Sdevaud/PCB/PCB.pdf

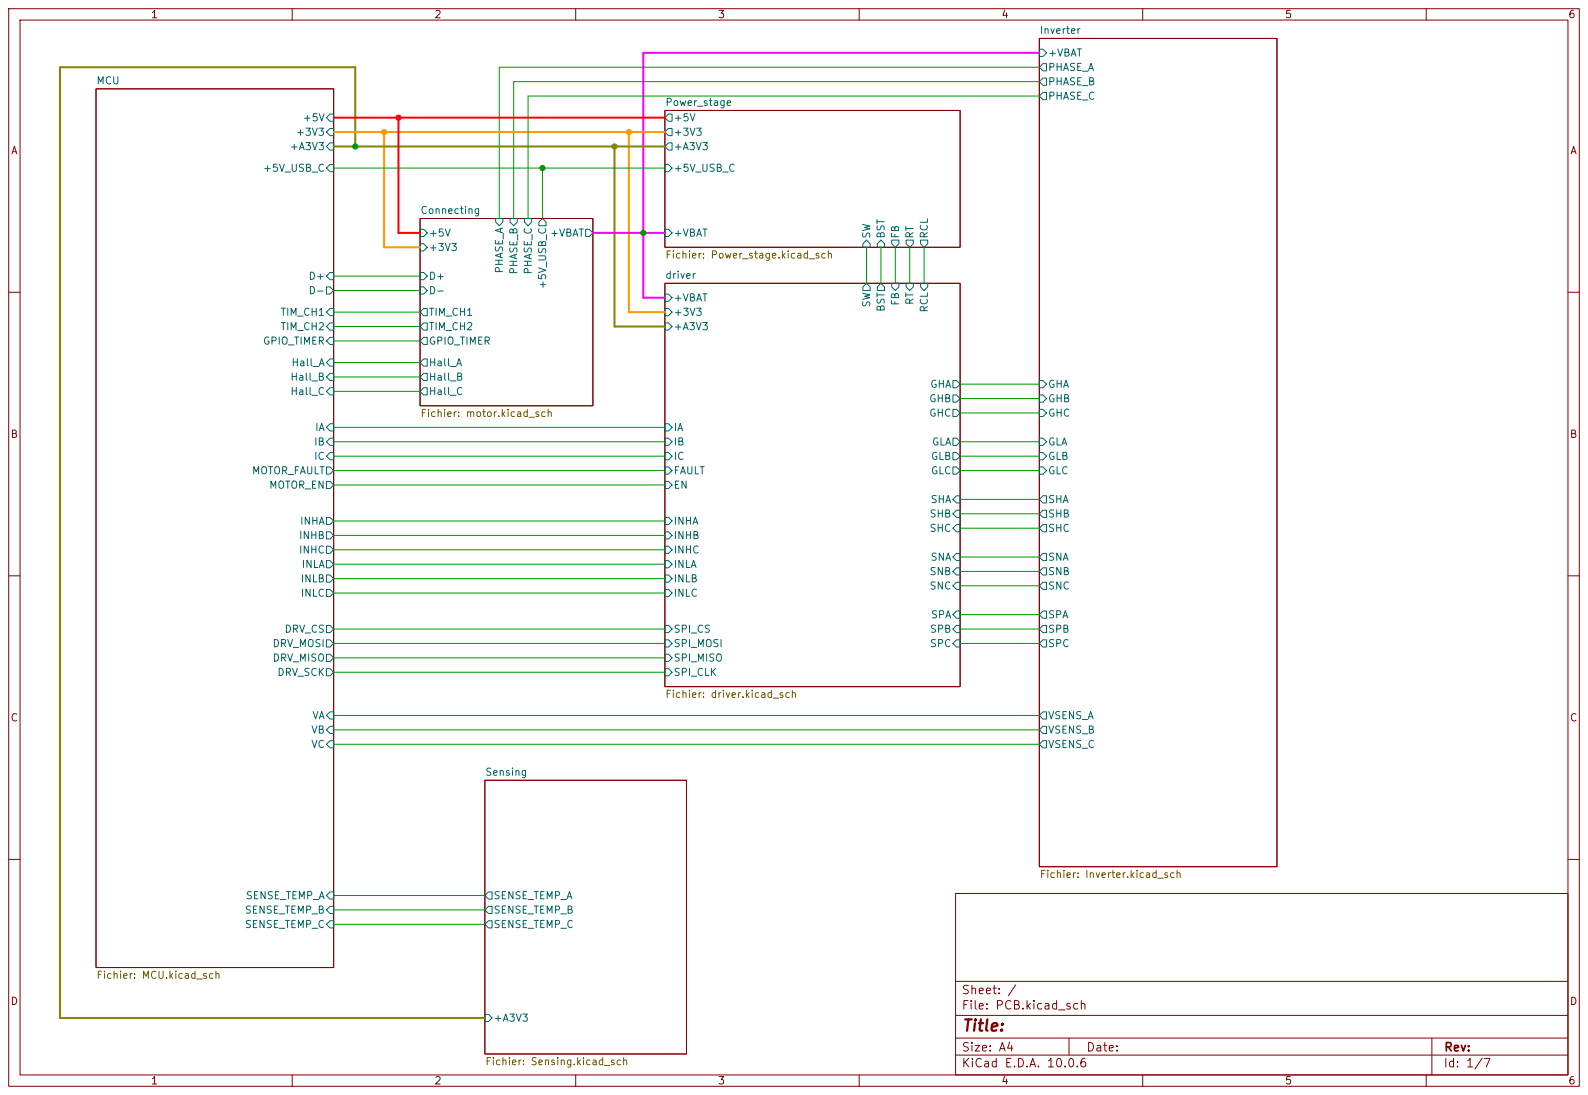
[picture p1: page 1]

Size: A4 | Rev:
KiCad E.D.A. 10.0.6 | Id: 1/7

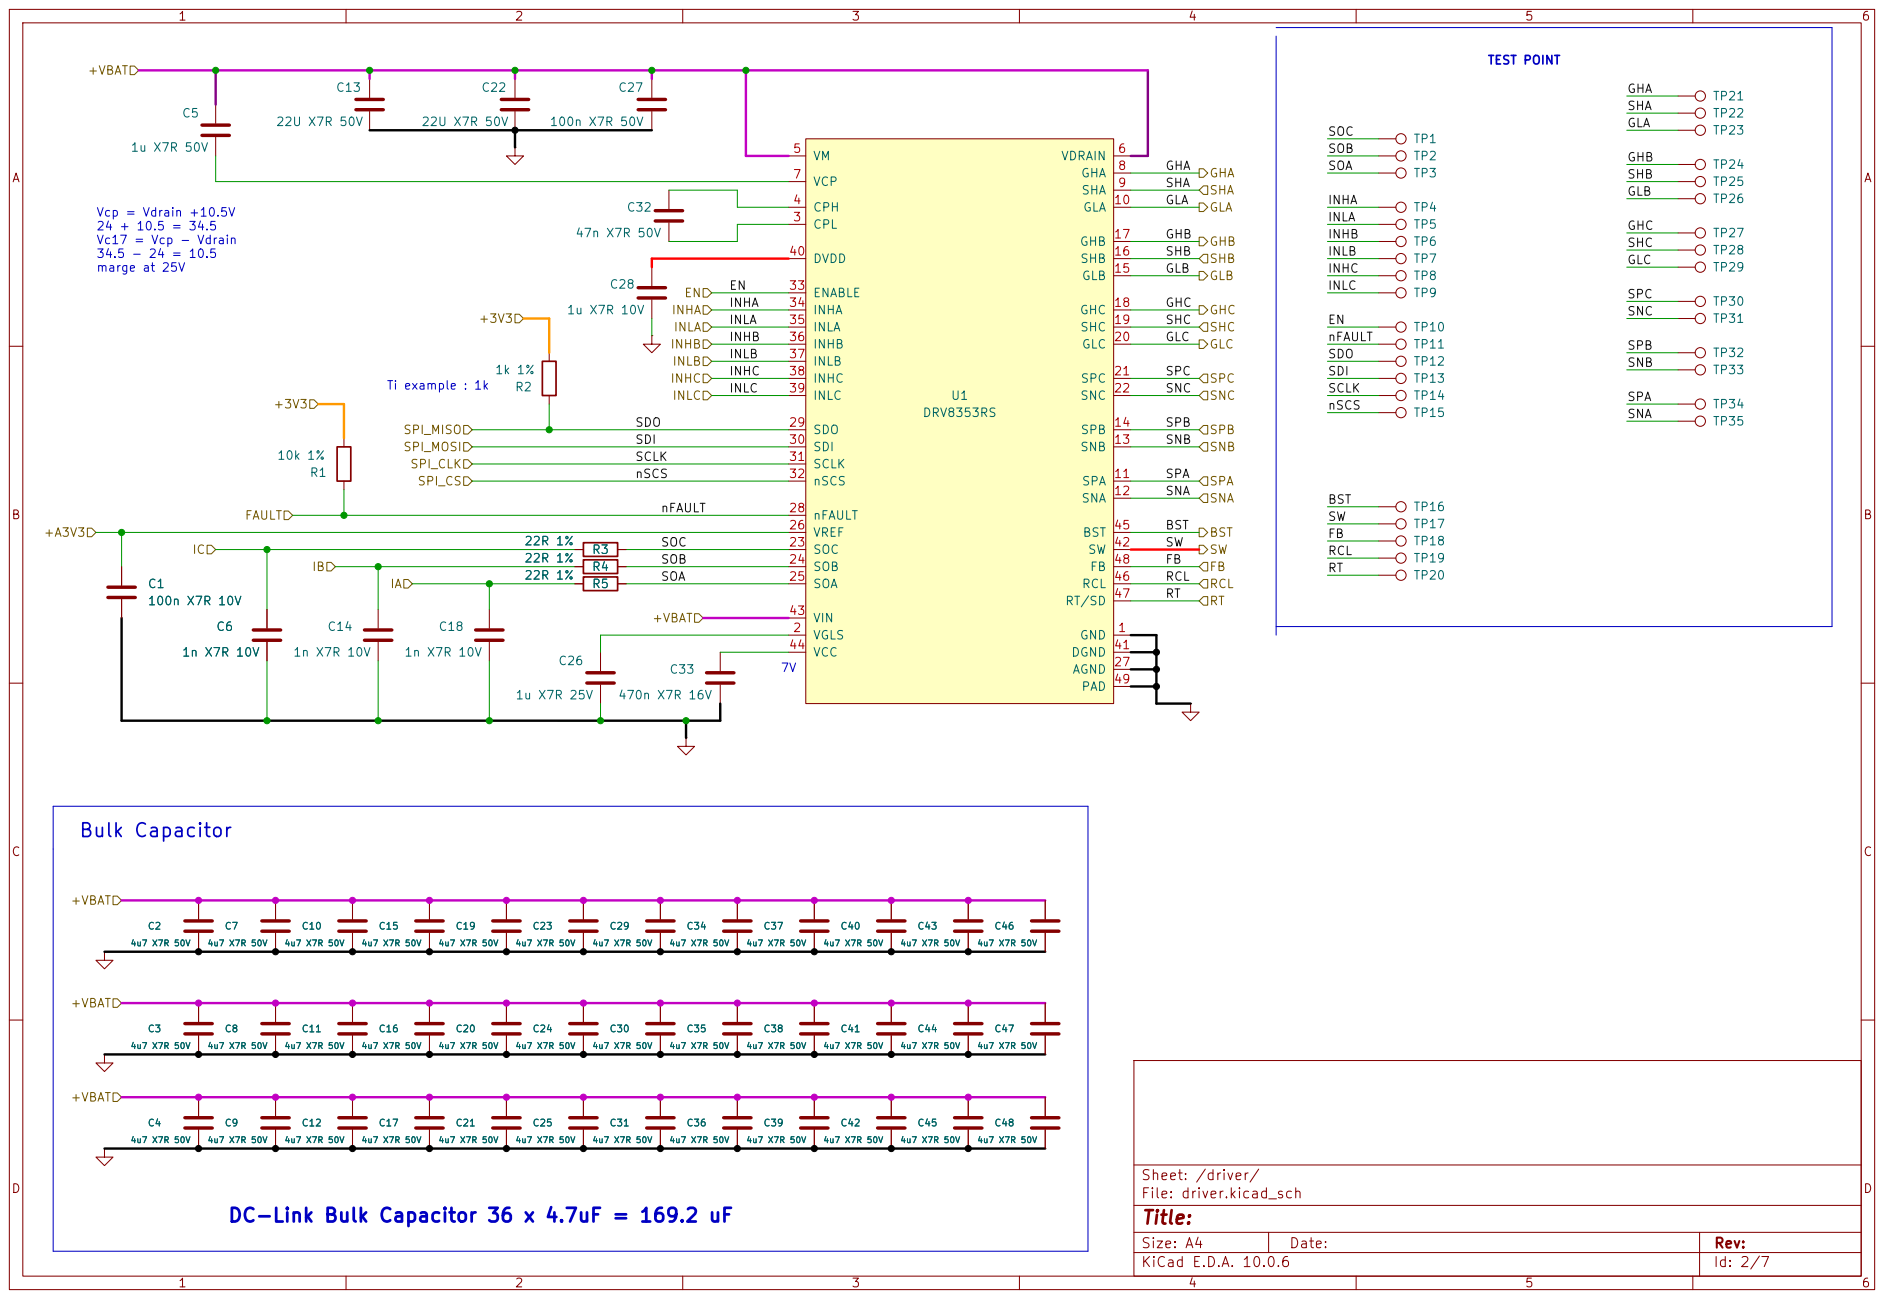
[picture p2: page 2]

TEST POINT 7V Bulk Capacitor
SPI_CS +VBAT

Vc17 = Vcp - Vdrain 34.5 - 24 = 10.5 marge at 25V

DC-Link Bulk Capacitor 36 x 4.7uF = 169.2 uF

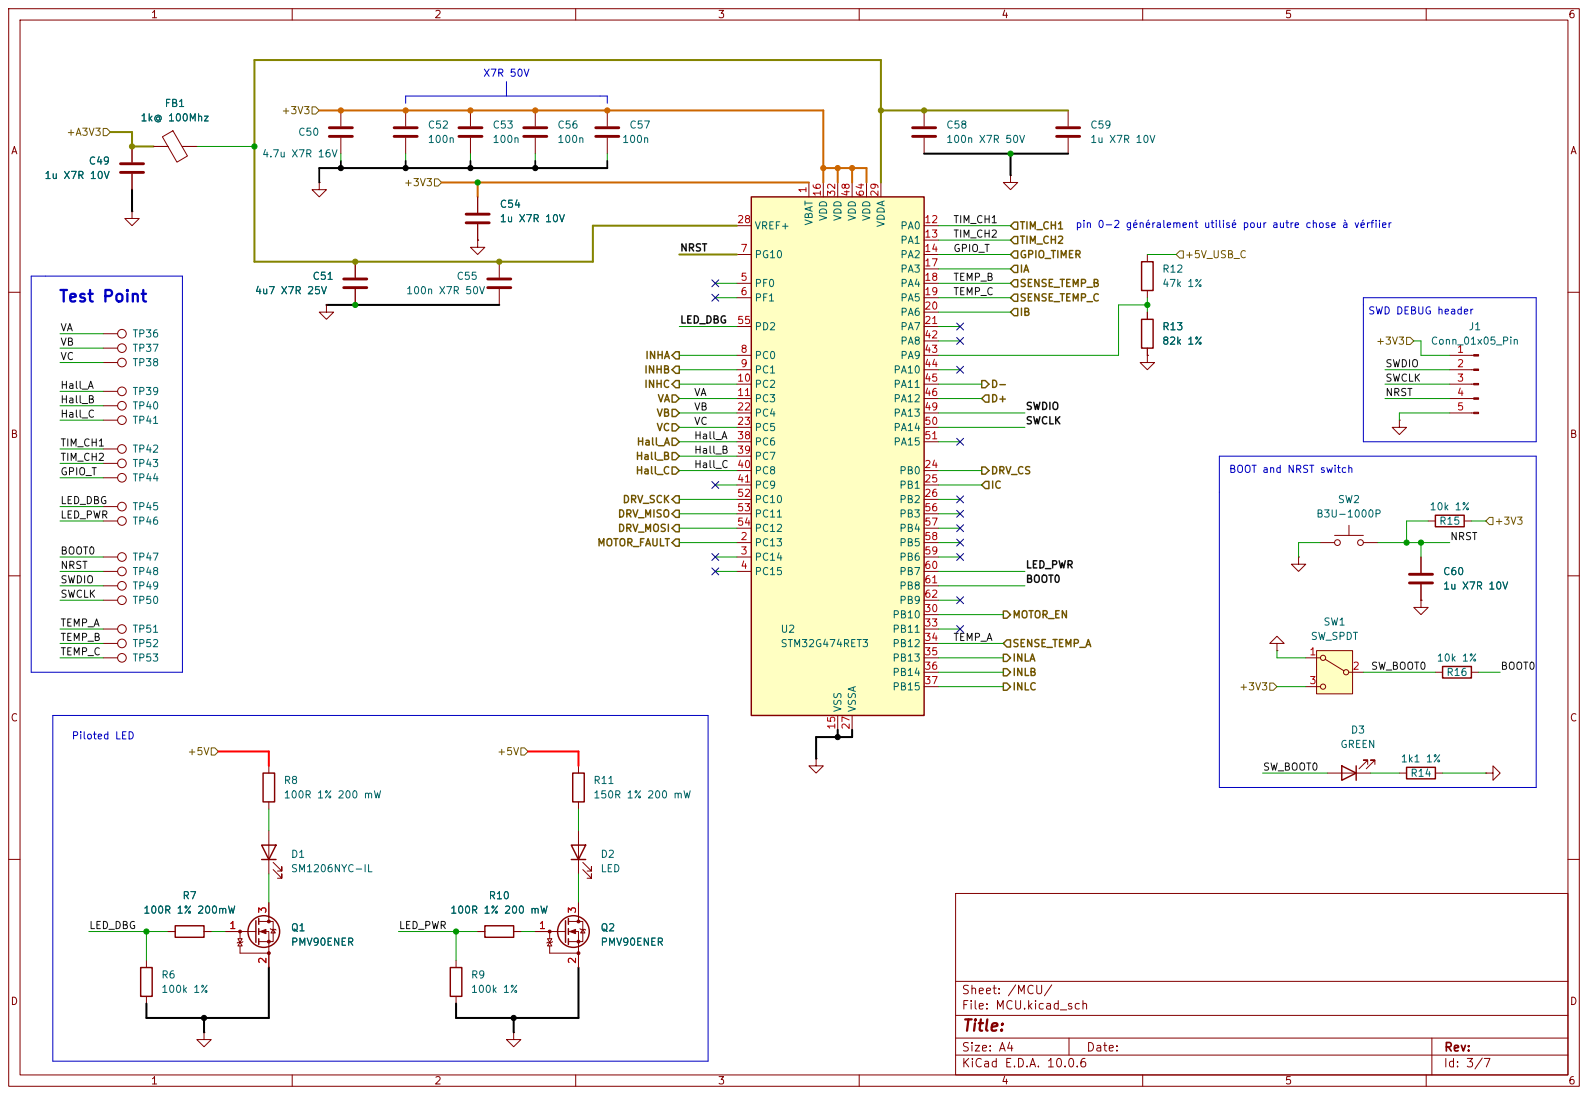
[picture p3: page 3]

pin 0-2 généralement utilisé pour autre chose à vérfiier Piloted LED

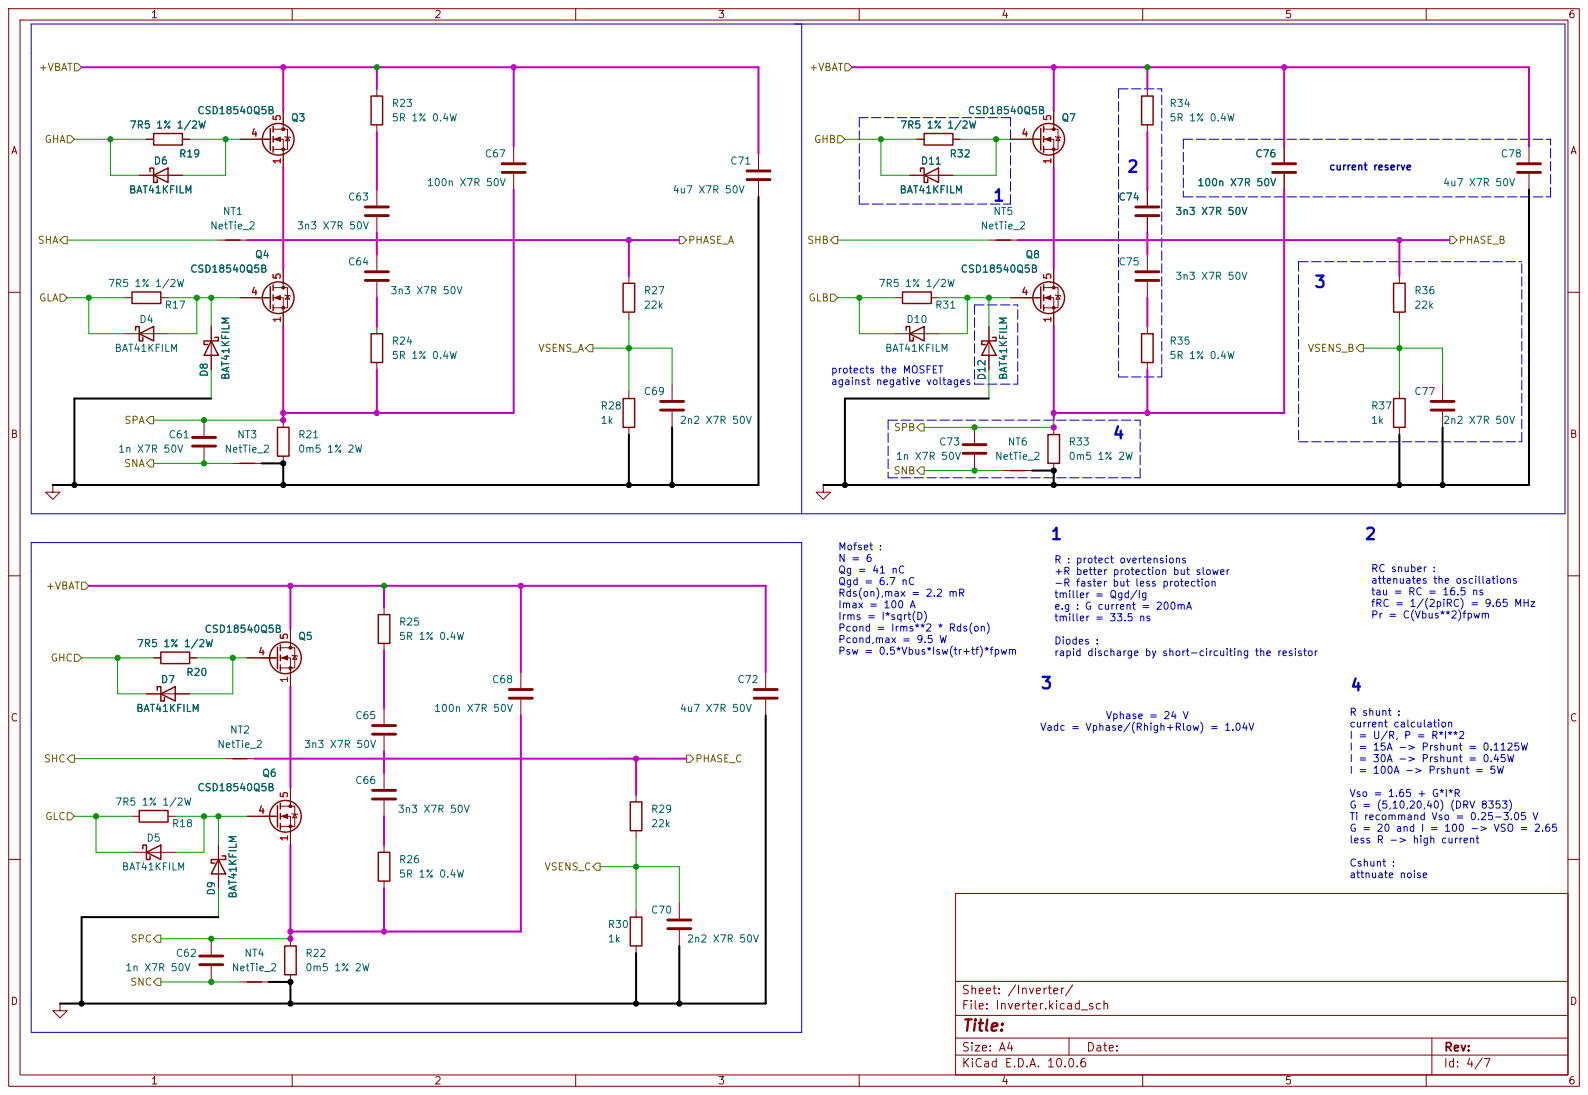
[picture p4: page 4]

Mofset : N = 6 Qg = 41 nC Qgd = 6.7 nC

RC snuber : attenuates the oscillations

Rds(on),max = 2.2 mR
Imax = 100 A
Irms = I*sqrt(D) Pcond = Irms**2 * Rds(on)

tau = RC = 16.5 ns
fRC = 1/(2piRC) = 9.65 MHz Pr = C(Vbus**2)fpwm

Pcond,max = 9.5 W
Psw = 0.5*Vbus*Isw(tr+tf)*fpwm

less R -> high current Cshunt : attnuate noise 3

Vso = 1.65 + G*I*R
G = (5,10,20,40) (DRV 8353) Ti recommand Vso = 0.25-3.05 V G = 20 and I = 100 -> VSO = 2.65

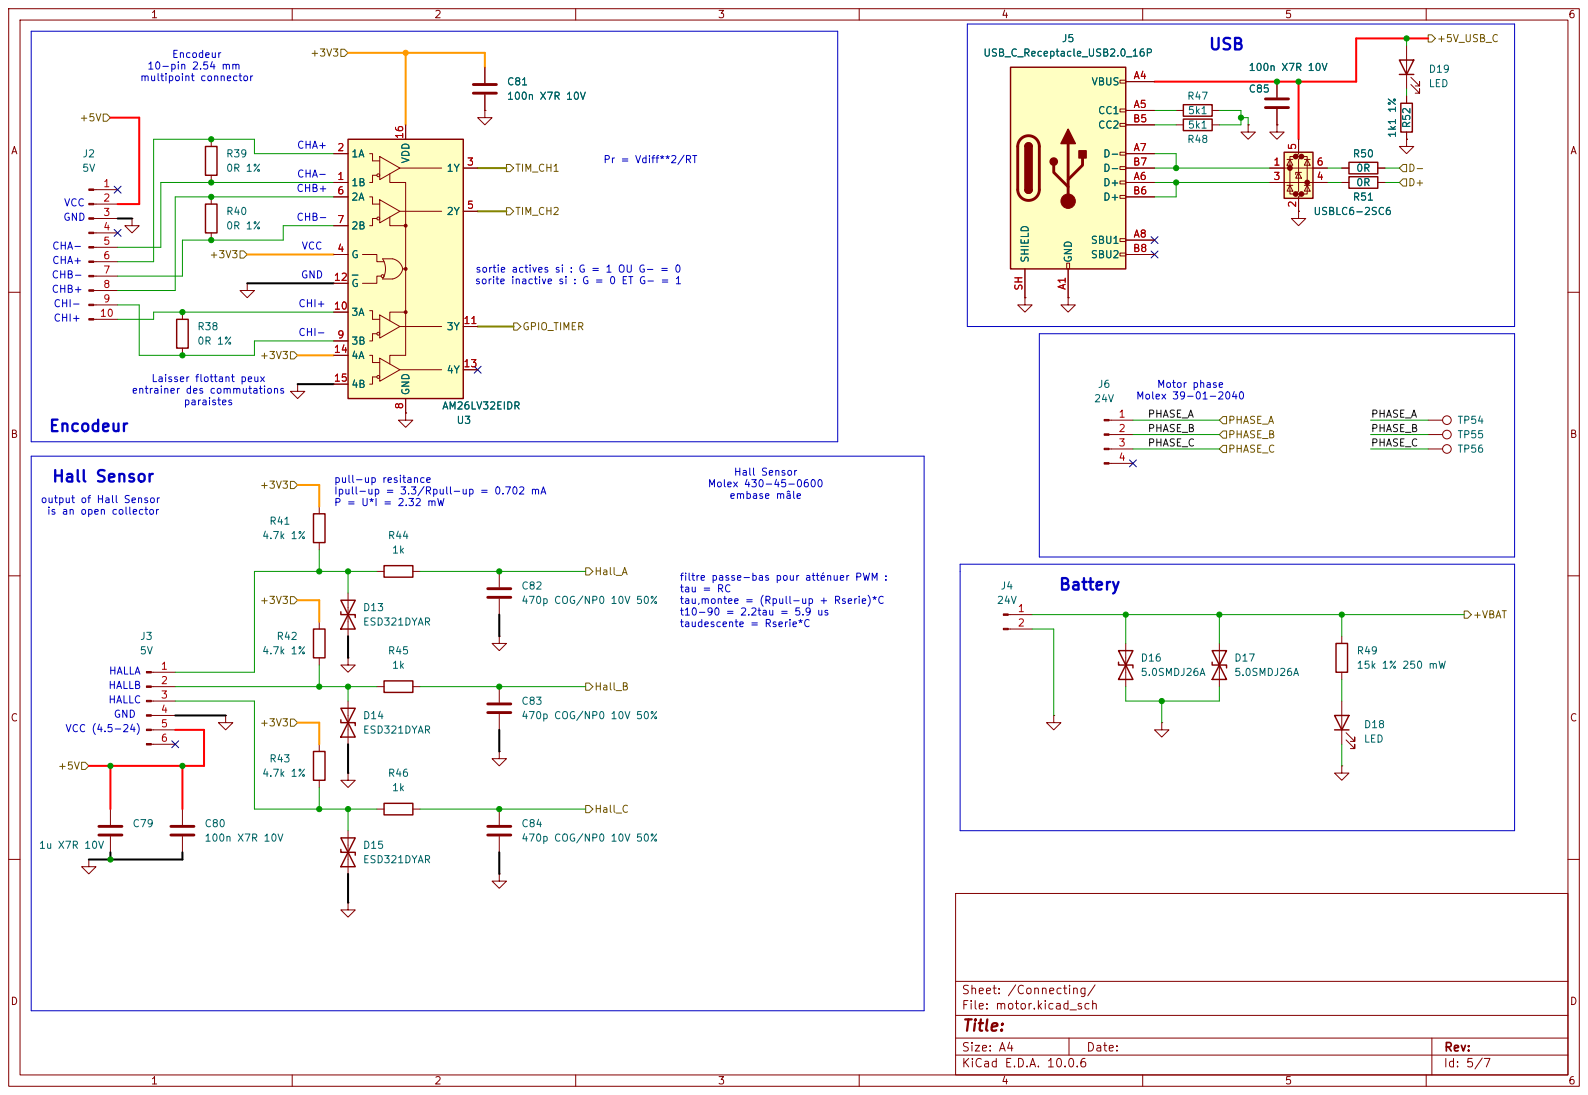
[picture p5: page 5]

Encodeur 10-pin 2.54 mm multipoint connector VCC

sortie actives si : G = 1 OU G- = 0
sorite inactive si : G = 0 ET G- = 1

CHI+
is an open collector VCC (4.5-24) HALLC HALLB

Laisser flottant peux entrainer des commutations paraistes

pull-up resitance
Ipull-up = 3.3/Rpull-up = 0.702 mA P = U*I = 2.32 mW

output of Hall Sensor

filtre passe-bas pour atténuer PWM :
tau = RC
tau,montee = (Rpull-up + Rserie)*C
t10-90 = 2.2tau = 5.9 us
taudescente = Rserie*C

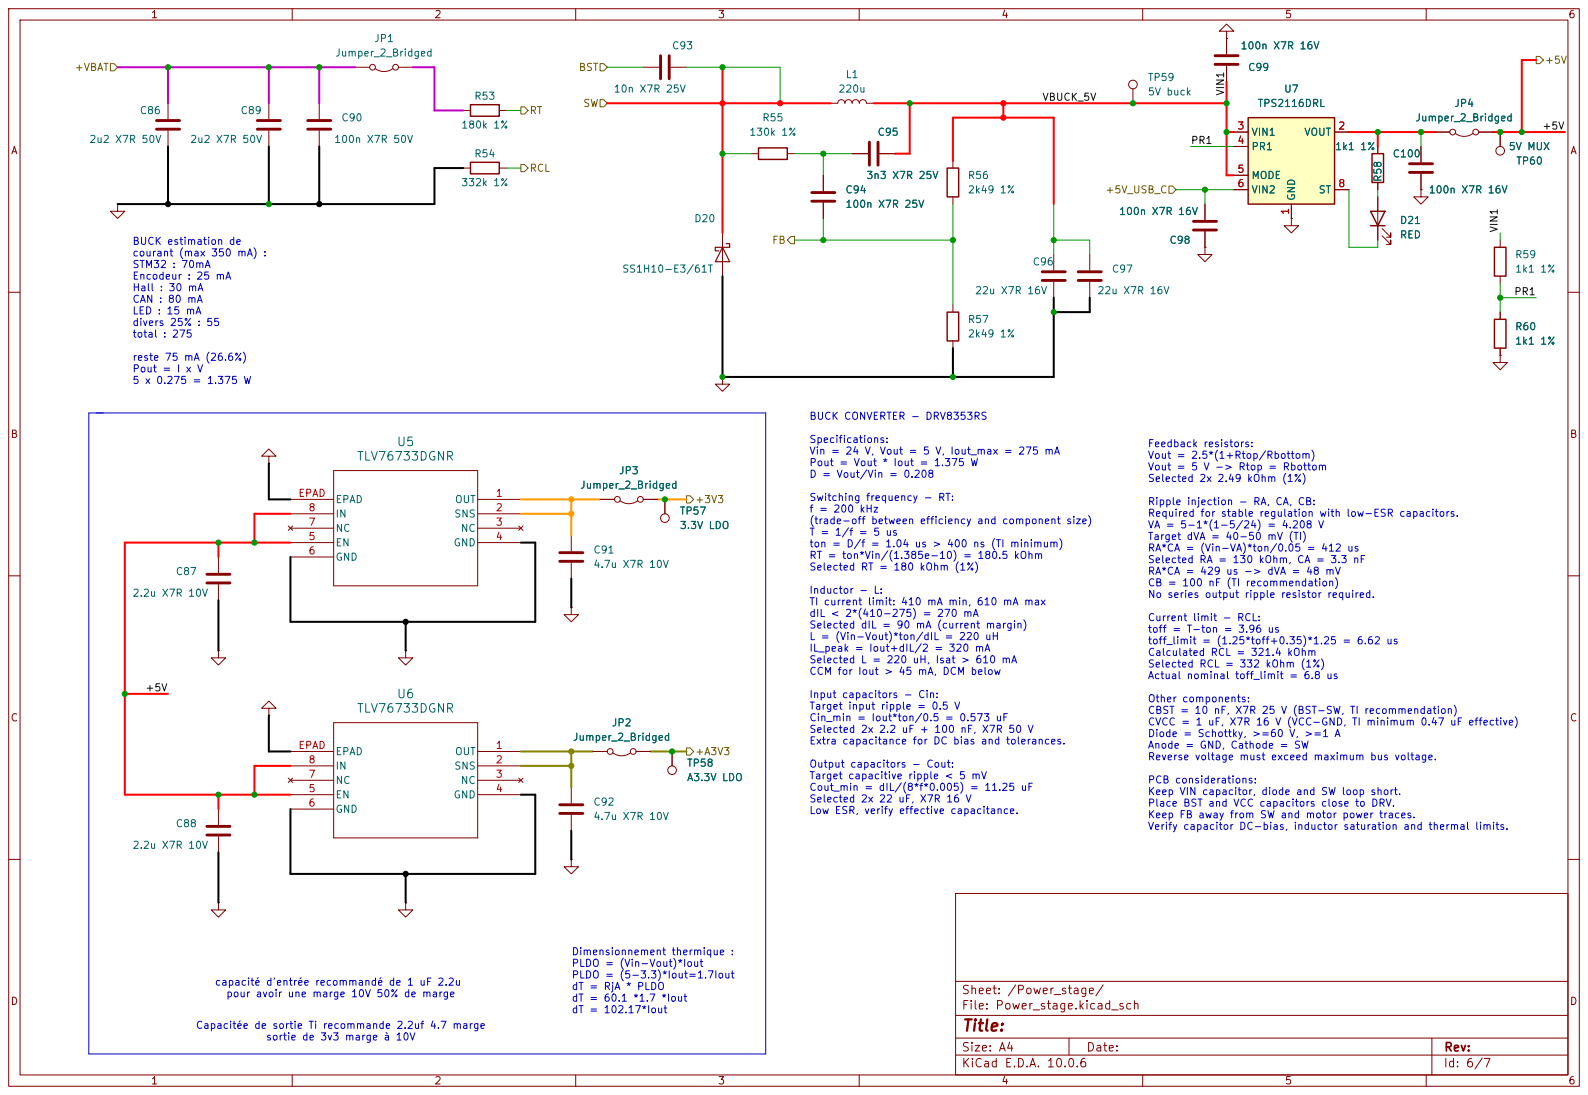
[picture p6: page 6]

BUCK estimation de courant (max 350 mA) : STM32 : 70mA Encodeur : 25 mA Hall : 30 mA CAN : 80 mA

Reverse voltage must exceed maximum bus voltage. PCB considerations: Keep VIN capacitor, diode and SW loop short. Place BST and VCC capacitors close to DRV. Keep FB away from SW and motor power traces. Verify capacitor DC-bias, inductor saturation and thermal limits. BUCK CONVERTER - DRV8353RS

Specifications: Vin = 24 V, Vout = 5 V, Iout_max = 275 mA Pout = Vout * Iout = 1.375 W

Feedback resistors: Vout = 2.5*(1+Rtop/Rbottom) Vout = 5 V -> Rtop = Rbottom

Switching frequency - RT: f = 200 kHz

Ripple injection - RA, CA, CB: Required for stable regulation with low-ESR capacitors. VA = 5-1*(1-5/24) = 4.208 V

(trade-off between efficiency and component size) T = 1/f = 5 us

Target dVA = 40-50 mV (TI) RA*CA = (Vin-VA)*ton/0.05 = 412 us Selected RA = 130 kOhm, CA = 3.3 nF RA*CA = 429 us -> dVA = 48 mV CB = 100 nF (TI recommendation) No series output ripple resistor required. Current limit - RCL: toff = T-ton = 3.96 us

ton = D/f = 1.04 us > 400 ns (TI minimum) RT = ton*Vin/(1.385e-10) = 180.5 kOhm

Inductor - L: TI current limit: 410 mA min, 610 mA max dIL < 2*(410-275) = 270 mA Selected dIL = 90 mA (current margin) L = (Vin-Vout)*ton/dIL = 220 uH

IL_peak = Iout+dIL/2 = 320 mA Selected L = 220 uH, Isat > 610 mA CCM for Iout > 45 mA, DCM below

toff_limit = (1.25*toff+0.35)*1.25 = 6.62 us Calculated RCL = 321.4 kOhm

Selected RCL = 332 kOhm (1%) Actual nominal toff_limit = 6.8 us Other components: CBST = 10 nF, X7R 25 V (BST-SW, TI recommendation) CVCC = 1 uF, X7R 16 V (VCC-GND, TI minimum 0.47 uF effective) Diode = Schottky, >=60 V, >=1 A

Input capacitors - Cin: Target input ripple = 0.5 V Cin_min = Iout*ton/0.5 = 0.573 uF Selected 2x 2.2 uF + 100 nF, X7R 50 V Extra capacitance for DC bias and tolerances. Output capacitors - Cout: Target capacitive ripple < 5 mV Cout_min = dIL/(8*f*0.005) = 11.25 uF Selected 2x 22 uF, X7R 16 V

Anode = GND, Cathode = SW

Low ESR, verify effective capacitance.

Dimensionnement thermique : PLDO = (Vin-Vout)*Iout PLDO = (5-3.3)*Iout=1.7Iout dT = RjA * PLDO

capacité d'entrée recommandé de 1 uF 2.2u pour avoir une marge 10V 50% de marge
dT = 60.1 *1.7 *Iout dT = 102.17*Iout Capacitée de sortie Ti recommande 2.2uf 4.7 marge

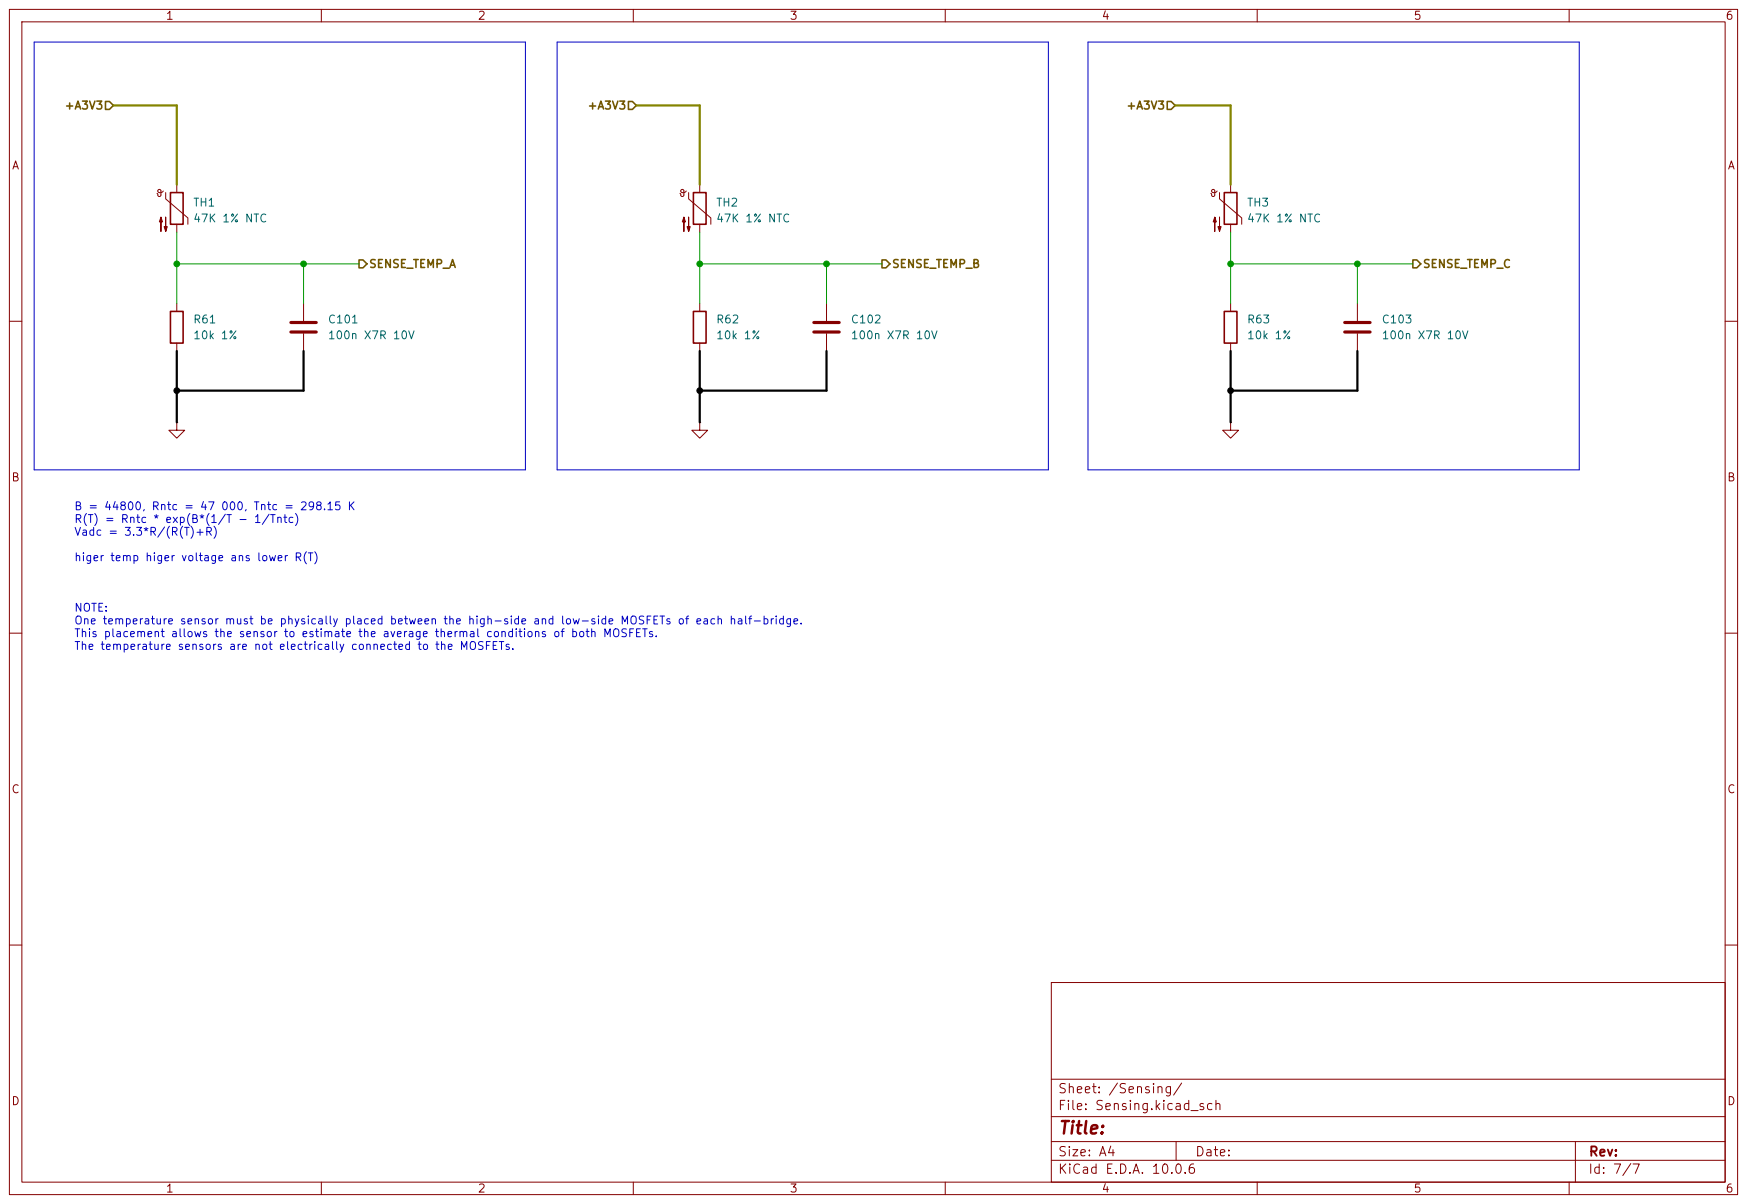
[picture p7: page 7]

R(T) = Rntc * exp(B*(1/T - 1/Tntc) Vadc = 3.3*R/(R(T)+R)

higer temp higer voltage ans lower R(T) NOTE: One temperature sensor must be physically placed between the high-side and low-side MOSFETs of each half-bridge. This placement allows the sensor to estimate the average thermal conditions of both MOSFETs. The temperature sensors are not electrically connected to the MOSFETs.
