Sdevaud/PCB/Inverter.kicad_sch

## KiCad design Inverter.kicad_sch (2026-11-09)

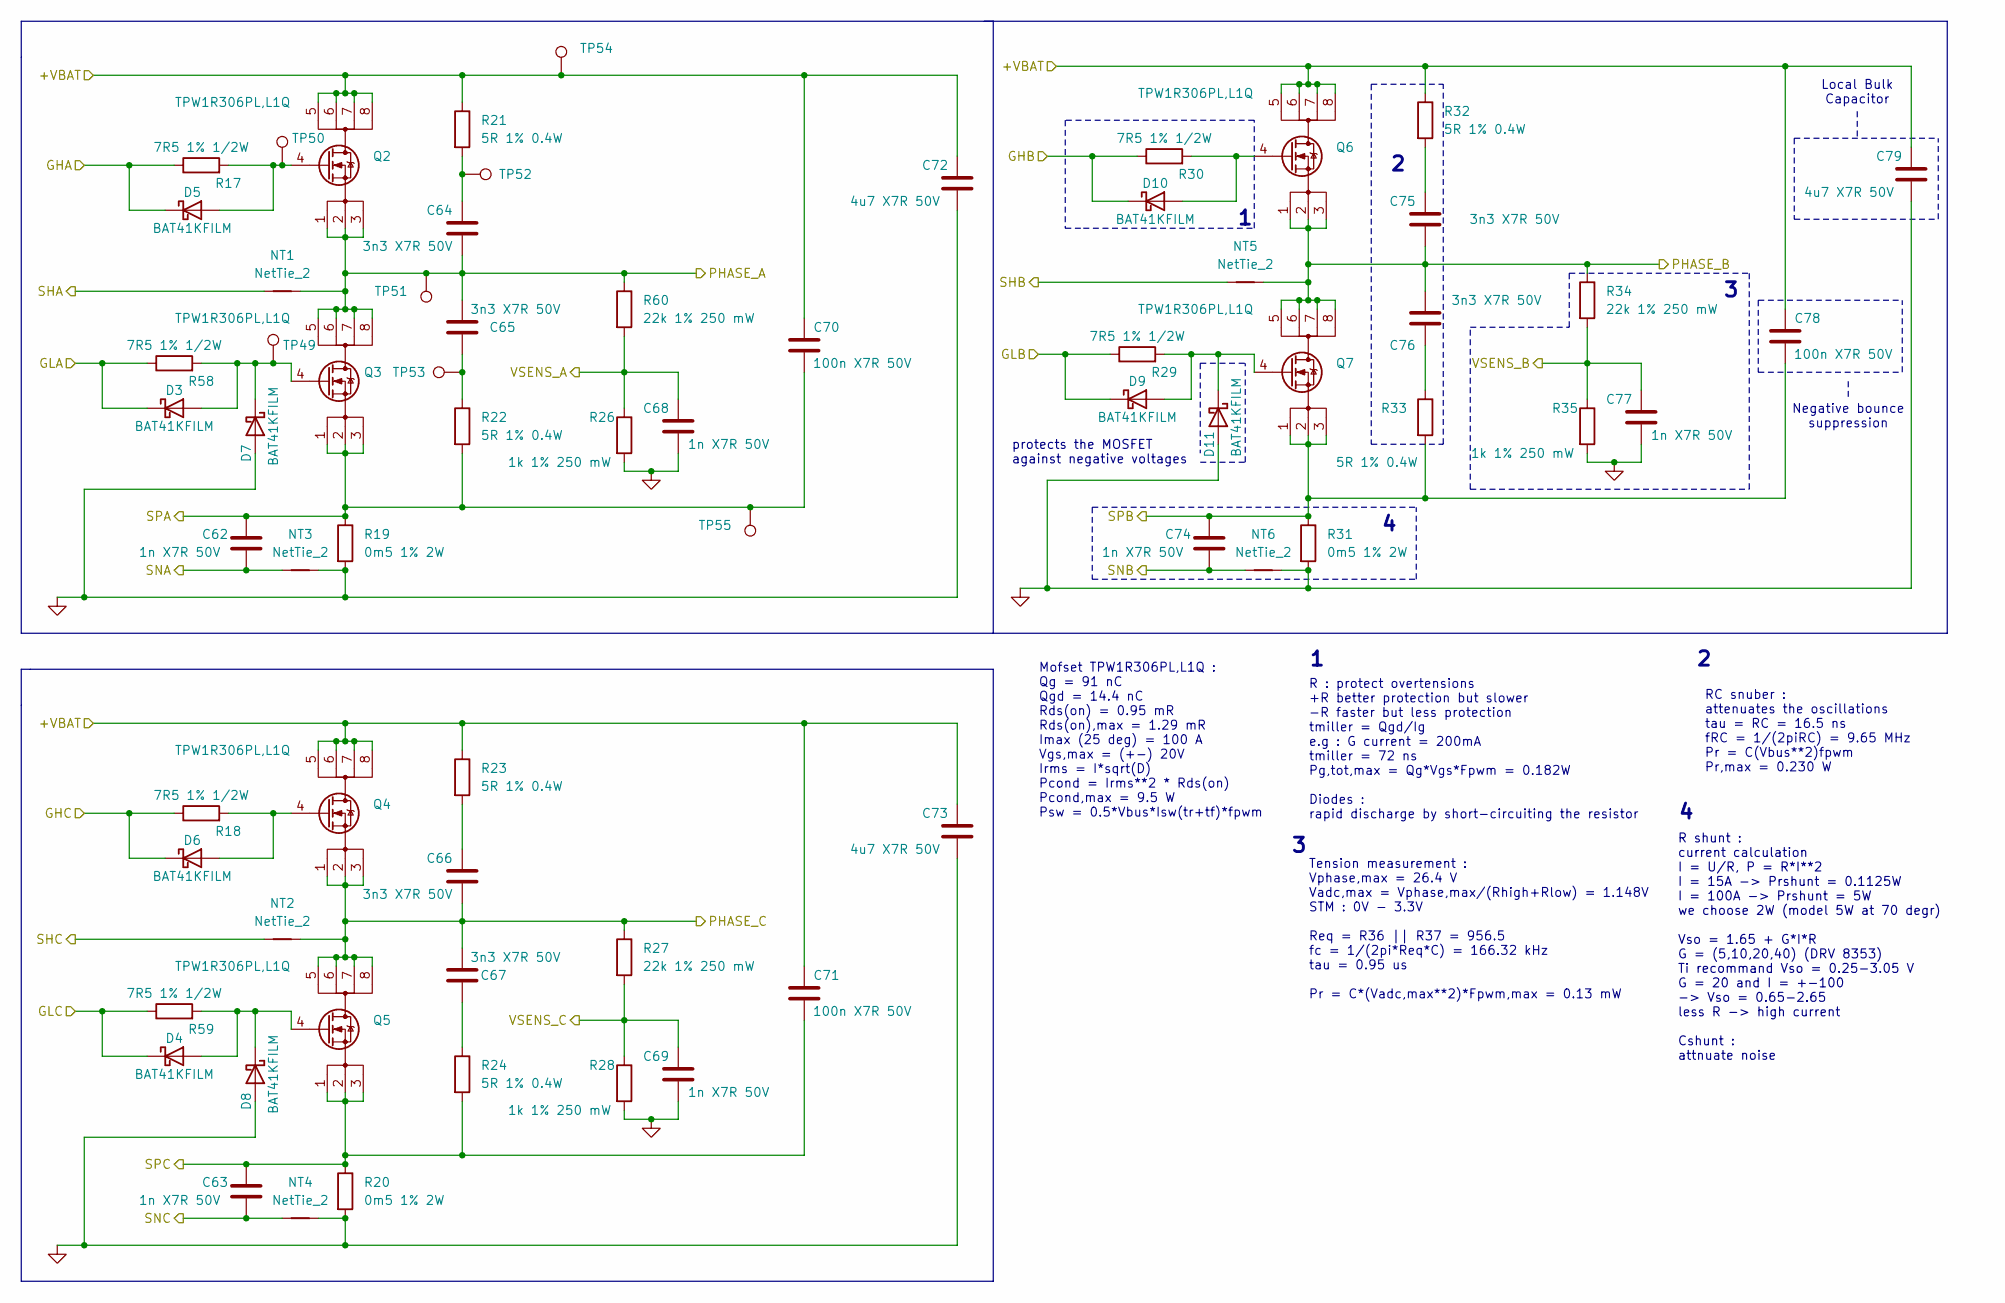
[picture p8: schematic Inverter.kicad_sch]

Parts:
C62, C63, C68, C69, C74, C77: 1n X7R 50V; C_0603_1608Metric
C64, C65, C66, C67, C75, C76: 3n3 X7R 50V; C_0603_1608Metric
C70, C71, C78: 100n X7R 50V; C_0603_1608Metric
C72, C73, C79: 4u7 X7R 50V; C_1210_3225Metric
D3, D4, D5, D6, D7, D8, D9, D10, D11: BAT41KFILM; D_SOD-523
NT1, NT2, NT3, NT4, NT5, NT6: NetTie_2; NetTie-2_SMD_Pad0.5mm
Q2, Q3, Q4, Q5, Q6, Q7: TPW1R306PL,L1Q; SOT95P237X112-3N
R17, R18, R29, R30, R58, R59: 7R5 1% 1/2W; R_0805_2012Metric
R19, R20, R31: 0m5 1% 2W; R_1206_3216Metric
R21, R22, R23, R24, R32, R33: 5R 1% 0.4W; R_0603_1608Metric
R26, R28, R35: 1k 1% 250 mW; R_0603_1608Metric
R27, R34, R60: 22k 1% 250 mW; R_0603_1608Metric
TP49, TP50, TP51, TP52, TP53, TP54, TP55: TestPoint; TestPoint_Pad_D2.0mm

Connections:
+VBAT: C70.1, C71.1, C72.1, C73.1, C78.1, C79.1, Q2.5 (D), Q2.6 (D), Q2.7 (D), Q2.8 (D), Q4.5 (D), Q4.6 (D), Q4.7 (D), Q4.8 (D), Q6.5 (D), Q6.6 (D), Q6.7 (D), Q6.8 (D), R21.1, R23.1, R32.1, TP54.1
GHA: D5.1 (K), R17.1
GHB: D10.1 (K), R30.1
GHC: D6.1 (K), R18.1
GLA: D3.1 (K), R58.1
GLB: D9.1 (K), R29.1
GLC: D4.1 (K), R59.1
GND: C68.2, C69.2, C72.2, C73.2, C77.2, C79.2, D7.2 (A), D8.2 (A), D11.2 (A), NT3.2, NT4.2, NT6.2, R19.2, R20.2, R26.2, R28.2, R31.2, R35.2
unnamed: C64.1, R21.2, TP52.1
unnamed: C65.2, R22.1, TP53.1
unnamed: C66.1, R23.2
unnamed: C67.2, R24.1
unnamed: C75.1, R32.2
unnamed: C76.2, R33.1
unnamed: D3.2 (A), D7.1 (K), Q3.4 (G), R58.2, TP49.1
unnamed: D4.2 (A), D8.1 (K), Q5.4 (G), R59.2
unnamed: D5.2 (A), Q2.4 (G), R17.2, TP50.1
unnamed: D6.2 (A), Q4.4 (G), R18.2
unnamed: D10.2 (A), Q6.4 (G), R30.2
unnamed: D9.2 (A), D11.1 (K), Q7.4 (G), R29.2
PHASE_A: C64.2, C65.1, NT1.2, Q2.1 (S), Q2.2 (S), Q2.3 (S), Q3.5 (D), Q3.6 (D), Q3.7 (D), Q3.8 (D), R60.1, TP51.1
PHASE_B: C75.2, C76.1, NT5.2, Q6.1 (S), Q6.2 (S), Q6.3 (S), Q7.5 (D), Q7.6 (D), Q7.7 (D), Q7.8 (D), R34.1
PHASE_C: C66.2, C67.1, NT2.2, Q4.1 (S), Q4.2 (S), Q4.3 (S), Q5.5 (D), Q5.6 (D), Q5.7 (D), Q5.8 (D), R27.1
SHA: NT1.1
SHB: NT5.1
SHC: NT2.1
SNA: C62.2, NT3.1
SNB: C74.2, NT6.1
SNC: C63.2, NT4.1
SPA: C62.1, C70.2, Q3.1 (S), Q3.2 (S), Q3.3 (S), R19.1, R22.2, TP55.1
SPB: C74.1, C78.2, Q7.1 (S), Q7.2 (S), Q7.3 (S), R31.1, R33.2
SPC: C63.1, C71.2, Q5.1 (S), Q5.2 (S), Q5.3 (S), R20.1, R24.2
VSENS_A: C68.1, R26.1, R60.2
VSENS_B: C77.1, R34.2, R35.1
VSENS_C: C69.1, R27.2, R28.1

Notes on the sheet:
Local Bulk Capacitor
R : protect overtensions +R better protection but slower -R faster but less protection tmiller = Qgd/Ig e.g : G current = 200mA tmiller = 72 ns Pg,tot,max = Qg*Vgs*Fpwm = 0.182W Diodes : rapid discharge by short-circuiting the resistor
Mofset TPW1R306PL,L1Q : Qg = 91 nC Qgd = 14.4 nC Rds(on) = 0.95 mR Rds(on),max = 1.29 mR Imax (25 deg) = 100 A Vgs,max = (+-) 20V Irms = I*sqrt(D) Pcond = Irms**2 * Rds(on) Pcond,max = 9.5 W Psw = 0.5*Vbus*Isw(tr+tf)*fpwm
RC snuber : attenuates the oscillations tau = RC = 16.5 ns fRC = 1/(2piRC) = 9.65 MHz Pr = C(Vbus**2)fpwm Pr,max = 0.230 W
Tension measurement : Vphase,max = 26.4 V Vadc,max = Vphase,max/(Rhigh+Rlow) = 1.148V STM : 0V - 3.3V Req = R36 || R37 = 956.5 fc = 1/(2pi*Req*C) = 166.32 kHz tau = 0.95 us Pr = C*(Vadc,max**2)*Fpwm,max = 0.13 mW
protects the MOSFET against negative voltages
R shunt : current calculation I = U/R, P = R*I**2 I = 15A -> Prshunt = 0.1125W I = 100A -> Prshunt = 5W we choose 2W (model 5W at 70 degr) Vso = 1.65 + G*I*R G = (5,10,20,40) (DRV 8353) Ti recommand Vso = 0.25-3.05 V G = 20 and I = +-100 -> Vso = 0.65-2.65 less R -> high current Cshunt : attnuate n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
Negative bounce suppression
