Sdevaud/PCB/MCU.kicad_sch

## KiCad design MCU.kicad_sch (2026-11-09)

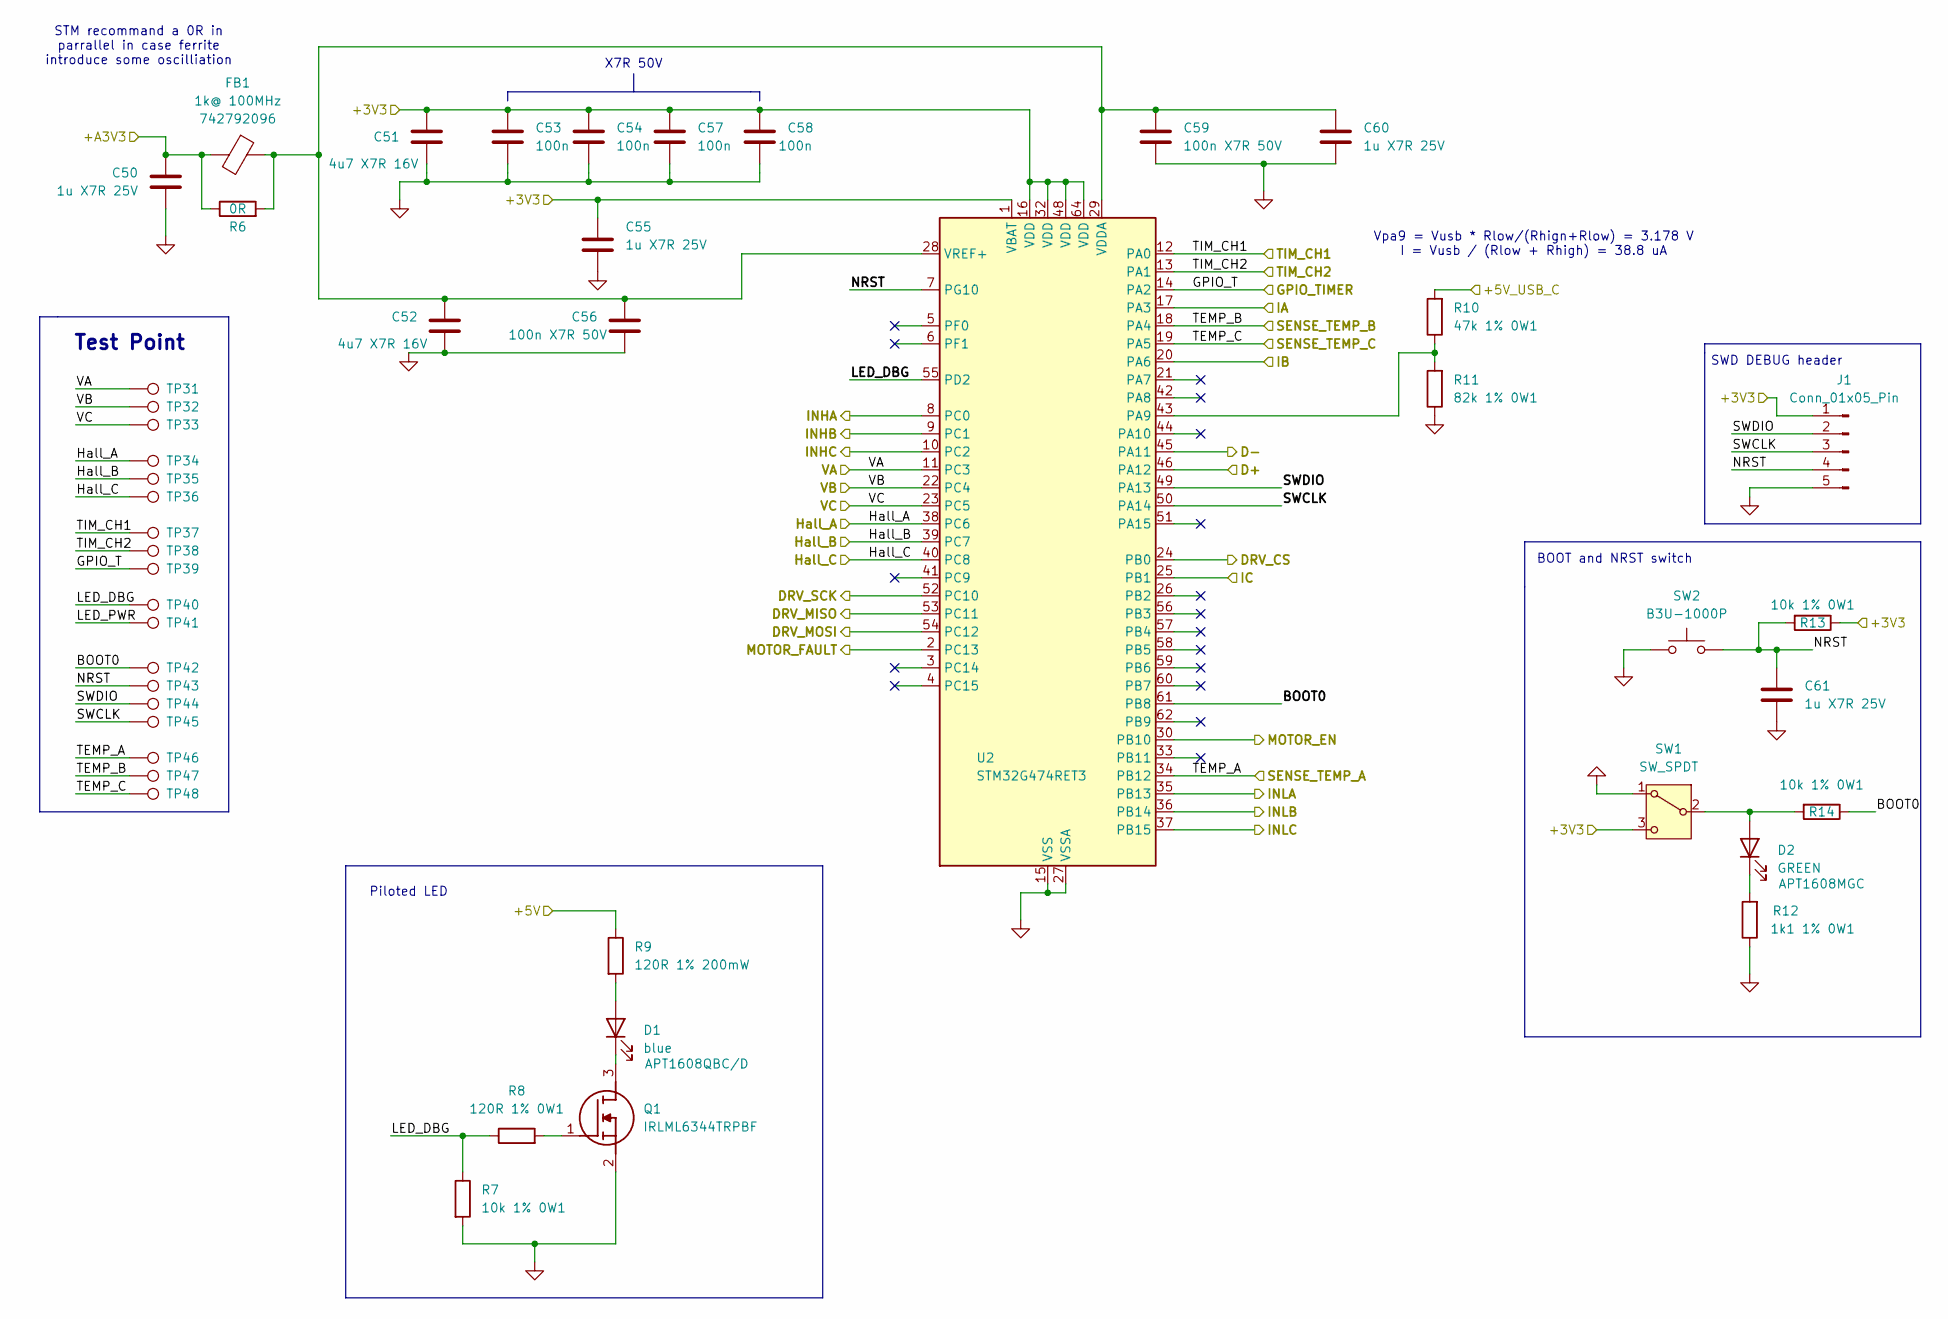
[picture p9: schematic MCU.kicad_sch]

Parts:
C50, C55, C60, C61: 1u X7R 25V; C_0603_1608Metric
C51, C52: 4u7 X7R 16V; C_0805_2012Metric
C53, C54, C57, C58: 100n; C_0603_1608Metric
C56, C59: 100n X7R 50V; C_0603_1608Metric
D1: blue; LED_1206_3216Metric
D2: GREEN; LED_0603_1608Metric
FB1: 1k@ 100MHz; R_0805_2012_DensityHigh
J1: Conn_01x05_Pin; PinHeader_1x05_P2.54mm_Vertical
Q1: IRLML6344TRPBF; SOT95P237X112-3N; Mouser Part Number 942-IRLML6344TRPBF
R6: 0R; R_0603_1608Metric
R7, R13, R14: 10k 1% 0W1; R_0603_1608Metric
R8: 120R 1% 0W1; R_0603_1608Metric
R9: 120R 1% 200mW; R_0603_1608Metric
R10: 47k 1% 0W1; R_0603_1608Metric
R11: 82k 1% 0W1; R_0603_1608Metric
R12: 1k1 1% 0W1; R_0603_1608Metric
SW1: SW_SPDT; SW_TH_Tactile_Omron_B3F-100x
SW2: B3U-1000P; SW_SPST_B3U-1000P
TP31, TP32, TP33, TP34, TP35, TP36, TP37, TP38, TP39, TP40, TP41, TP42, TP43, TP44, TP45, TP46, TP47, TP48: TestPoint; TestPoint_Pad_D2.0mm
U2: STM32G474RET3; LQFP64-10x10mm

Connections:
+3V3: C51.1, C53.1, C54.1, C55.1, C57.1, C58.1, J1.1, R13.1, SW1.3 (C), U2.1 (VBAT), U2.16 (VDD), U2.32 (VDD), U2.48 (VDD), U2.64 (VDD)
+5V: R9.1
+5V_USB_C: R10.2
+A3V3: C50.1, FB1.2, R6.1
BOOT0: R14.1, TP42.1, U2.61 (PB8)
D+: U2.46 (PA12)
D-: U2.45 (PA11)
DRV_CS: U2.24 (PB0)
DRV_MISO: U2.53 (PC11)
DRV_MOSI: U2.54 (PC12)
DRV_SCK: U2.52 (PC10)
GND: C50.2, C51.2, C52.2, C53.2, C54.2, C55.2, C56.2, C57.2, C58.2, C59.2, C60.2, C61.2, J1.5, Q1.2 (S), R7.2, R11.1, R12.1, SW1.1 (A), SW2.1 (A), SW2.2 (A), U2.15 (VSS), U2.27 (VSSA), U2.31 (VSS), U2.47 (VSS), U2.63 (VSS)
GPIO_T: TP39.1, U2.14 (PA2)
Hall_A: TP34.1, U2.38 (PC6)
Hall_B: TP35.1, U2.39 (PC7)
Hall_C: TP36.1, U2.40 (PC8)
IA: U2.17 (PA3)
IB: U2.20 (PA6)
IC: U2.25 (PB1)
INHA: U2.8 (PC0)
INHB: U2.9 (PC1)
INHC: U2.10 (PC2)
INLA: U2.35 (PB13)
INLB: U2.36 (PB14)
INLC: U2.37 (PB15)
LED_DBG: R7.1, R8.1, TP40.1, U2.55 (PD2)
LED_PWR: TP41.1
MOTOR_EN: U2.30 (PB10)
MOTOR_FAULT: U2.2 (PC13)
NRST: C61.1, J1.4, R13.2, SW2.3 (B), SW2.4 (B), TP43.1, U2.7 (PG10)
unnamed: C52.1, C56.1, C59.1, C60.1, FB1.1, R6.2, U2.28 (VREF+), U2.29 (VDDA)
unnamed: D1.1 (K), Q1.3 (D)
unnamed: D1.2 (A), R9.2
unnamed: D2.1 (K), R12.2
unnamed: D2.2 (A), R14.2, SW1.2 (B)
unnamed: Q1.1 (G), R8.2
unnamed: R10.1, R11.2, U2.43 (PA9)
SENSE_TEMP_A: TP46.1, U2.34 (PB12)
SENSE_TEMP_B: TP47.1, U2.18 (PA4)
SENSE_TEMP_C: TP48.1, U2.19 (PA5)
SWCLK: J1.3, TP45.1, U2.50 (PA14)
SWDIO: J1.2, TP44.1, U2.49 (PA13)
TIM_CH1: TP37.1, U2.12 (PA0)
TIM_CH2: TP38.1, U2.13 (PA1)
VA: TP31.1, U2.11 (PC3)
VB: TP32.1, U2.22 (PC4)
VC: TP33.1, U2.23 (PC5)

Notes on the sheet:
BOOT and NRST switch
STM recommand a 0R in parrallel in case ferrite introduce some oscilliation
SWD DEBUG header
Piloted LED
X7R 50V
Vpa9 = Vusb * Rlow/(Rhign+Rlow) = 3.178 V I = Vusb / (Rlow + Rhigh) = 38.8 uA
Test Point
