Sdevaud/PCB/Power - Generation.kicad_sch

## KiCad design Power - Generation.kicad_sch (2026-11-09)

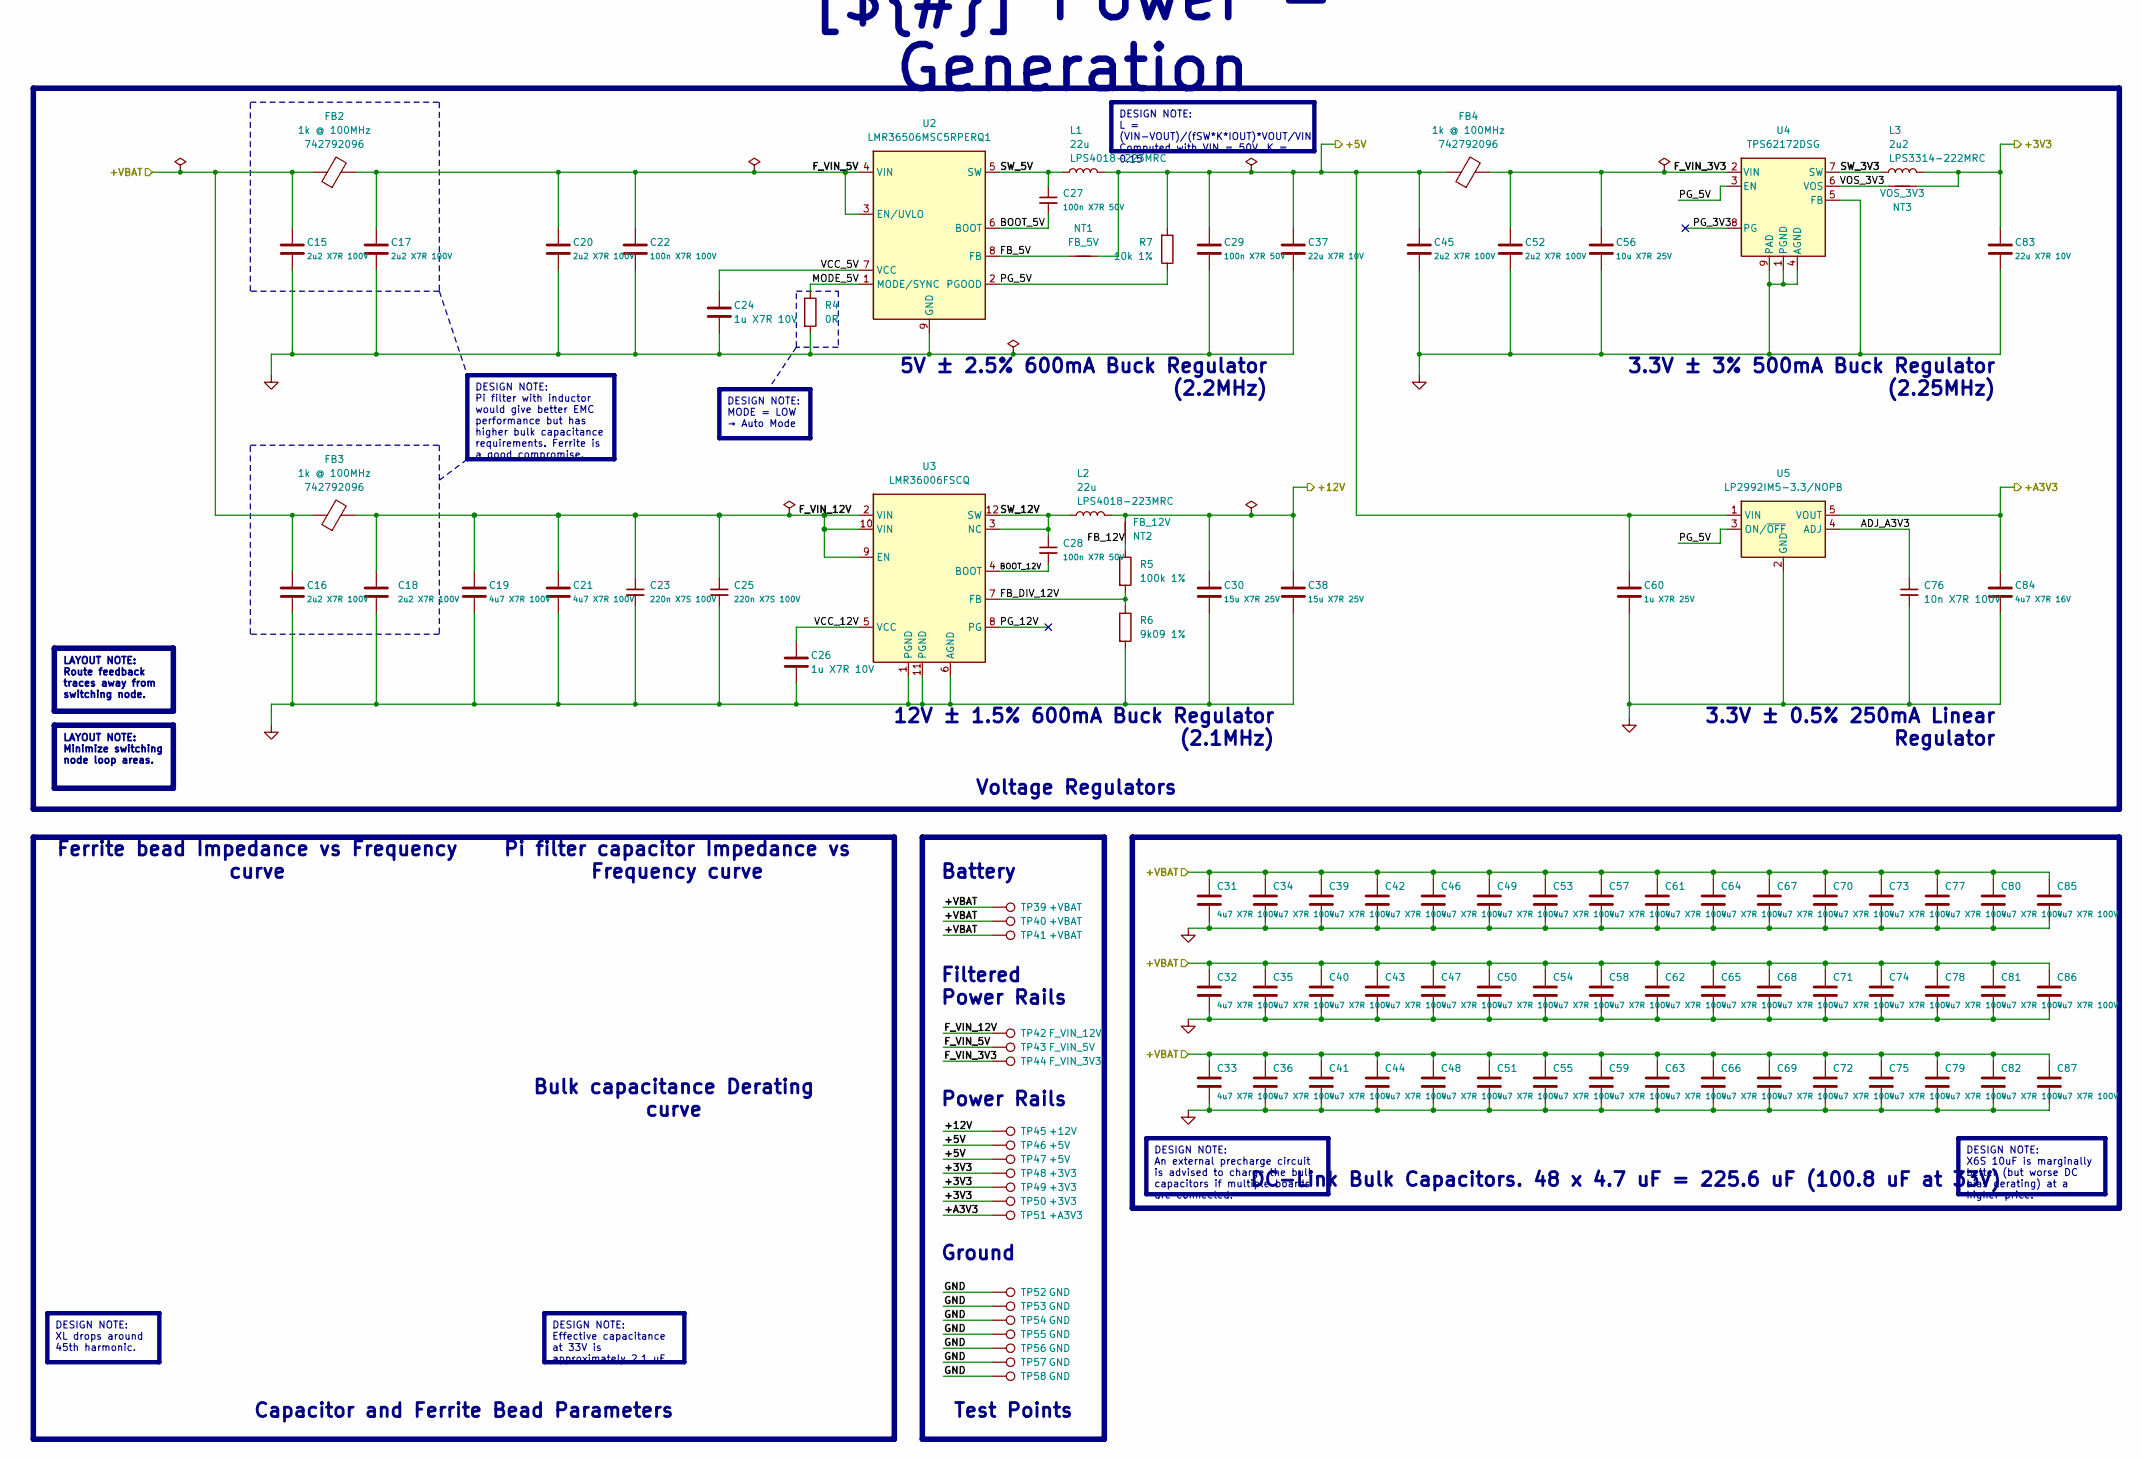
[picture p10: schematic Power - Generation.kicad_sch, part in row 2, column 1]

Parts:
C15, C16, C17, C18, C20, C45, C52: 2u2 X7R 100V; R_0805_2012_DensityHigh; Manufacturer Part Number CGA4J1X7R2A225K125AC
C19, C21, C31, C32, C33, C34, C35, C36, C39, C40, C41, C42, C43, C44, C46, C47, C48, C49, C50, C51, C53, C54, C55, C57, C58, C59, C61, C62, C63, C64, C65, C66, C67, C68, C69, C70, C71, C72, C73, C74, C75, C77, C78, C79, C80, C81, C82, C85, C86, C87: 4u7 X7R 100V; C_1206_3216_DensityHigh; Manufacturer Part Number GRJ31CZ72A475KE01L
C22: 100n X7R 100V; C_0603_1608_DensityHigh; Manufacturer Part Number HMK107B7104KAHT
C23, C25: 220n X7S 100V; C_0603_1608_DensityHigh; Manufacturer Part Number HMK107C7224KAHTE
C24, C26: 1u X7R 10V; C_0402_1005_DensityHigh; Manufacturer Part Number GRM155Z71A105KE01J
C27, C28, C29: 100n X7R 50V; C_0402_1005_DensityHigh; Manufacturer Part Number GCM155R71H104KE02J
C30, C38: 15u X7R 25V; C_1210_3225_DensityHigh; Manufacturer Part Number CGA6M3X7R1E156M200AB
C37, C83: 22u X7R 10V; C_0805_2012_DensityHighest; Manufacturer Part Number GRM21BZ71A226ME15L
C56: 10u X7R 25V; C_0805_2012_DensityHighest; Manufacturer Part Number GRM21BZ71E106KE15L
C60: 1u X7R 25V; C_0603_1608_DensityHigh; Manufacturer Part Number TMK107AB7105KAHT
C76: 10n X7R 100V; C_0402_1005_DensityHigh; Manufacturer Part Number HMR105B7103KV-F
C84: 4u7 X7R 16V; C_0603_1608_DensityHigh; Manufacturer Part Number GRM188Z71C475KE21J
FB2, FB3, FB4: 1k @ 100MHz; R_0805_2012_DensityHigh; Manufacturer Part Number 742792096
L1, L2: 22u; L_Coilcraft_LPS4018; Manufacturer Part Number LPS4018-223MRC
L3: 2u2; L_Coilcraft_LPS3314; Manufacturer Part Number LPS3314-222MRC
NT1: FB_5V; NetTie-2_SMD_Pad0.2mm
NT2: FB_12V; NetTie-2_SMD_Pad0.2mm
NT3: VOS_3V3; NetTie-2_SMD_Pad0.2mm
R4: 0R; R_0402_1005_DensityHigh; Manufacturer Part Number ERJ-2GE0R00X
R5: 100k 1%; R_0402_1005_DensityHigh; Manufacturer Part Number RT0402FRE07100KL
R6: 9k09 1%; R_0402_1005_DensityHigh; Manufacturer Part Number RT0402FRE079K09L
R7: 10k 1%; R_0402_1005_DensityHigh; Manufacturer Part Number RT0402FRE0710KL
TP39, TP40, TP41: +VBAT; TestPoint_Pad_D0.5mm_Front
TP42: F_VIN_12V; TestPoint_Pad_D0.5mm_Front
TP43: F_VIN_5V; TestPoint_Pad_D0.5mm_Front
TP44: F_VIN_3V3; TestPoint_Pad_D0.5mm_Back
TP45: +12V; TestPoint_Pad_D0.5mm_Front
TP46: +5V; TestPoint_Pad_D0.5mm_Front
TP47: +5V; TestPoint_Pad_D0.5mm_Back
TP48, TP49: +3V3; TestPoint_Pad_D0.5mm_Front
TP50: +3V3; TestPoint_Pad_D0.5mm_Back
TP51: +A3V3; TestPoint_Pad_D0.5mm_Front
TP52, TP53, TP54, TP55, TP56, TP57: GND; TestPoint_Pad_D0.5mm_Front
TP58: GND; TestPoint_Pad_D0.5mm_Back
U2: LMR36506MSC5RPERQ1; LMR36503; Manufacturer Part Number LMR36503MSC5RPERQ1
U3: LMR36006FSCQ; LMR36006; Manufacturer Part Number LMR36006FSCQRNXTQ1
U4: TPS62172DSG; WSON-8-1EP_2x2mm_P0.5mm_EP0.9x1.6mm_ThermalVias; Manufacturer Part Number TPS62172DSGR
U5: LP2992IM5-3.3/NOPB; SOT95P280X145-5N; Manufacturer Part Number LP2992IM5-3.3/NOPB

Connections:
+3V3: C83.1, L3.2, NT3.2, TP48.1, TP49.1, TP50.1
+5V: C29.1, C37.1, C45.1, C60.1, FB4.1, L1.2, NT1.1, R7.2, TP46.1, TP47.1, U5.1 (VIN)
+12V: C30.1, C38.1, L2.2, NT2.2, TP45.1
+A3V3: C84.1, TP51.1, U5.5 (VOUT)
+VBAT: C15.1, C16.1, C31.1, C32.1, C33.1, C34.1, C35.1, C36.1, C39.1, C40.1, C41.1, C42.1, C43.1, C44.1, C46.1, C47.1, C48.1, C49.1, C50.1, C51.1, C53.1, C54.1, C55.1, C57.1, C58.1, C59.1, C61.1, C62.1, C63.1, C64.1, C65.1, C66.1, C67.1, C68.1, C69.1, C70.1, C71.1, C72.1, C73.1, C74.1, C75.1, C77.1, C78.1, C79.1, C80.1, C81.1, C82.1, C85.1, C86.1, C87.1, FB2.1, FB3.1, TP39.1, TP40.1, TP41.1
ADJ_A3V3: C76.1, U5.4 (ADJ)
BOOT_5V: C27.2, U2.6 (BOOT)
BOOT_12V: C28.2, U3.4 (BOOT)
FB_5V: NT1.2, U2.8 (FB)
FB_12V: NT2.1, R5.1
FB_DIV_12V: R5.2, R6.1, U3.7 (FB)
F_VIN_3V3: C52.1, C56.1, FB4.2, TP44.1, U4.2 (VIN)
F_VIN_5V: C17.1, C20.1, C22.1, FB2.2, TP43.1, U2.3 (EN/UVLO), U2.4 (VIN)
F_VIN_12V: C18.1, C19.1, C21.1, C23.1, C25.1, FB3.2, TP42.1, U3.2 (VIN), U3.9 (EN), U3.10 (VIN)
GND: C15.2, C16.2, C17.2, C18.2, C19.2, C20.2, C21.2, C22.2, C23.2, C24.2, C25.2, C26.2, C29.2, C30.2, C31.2, C32.2, C33.2, C34.2, C35.2, C36.2, C37.2, C38.2, C39.2, C40.2, C41.2, C42.2, C43.2, C44.2, C45.2, C46.2, C47.2, C48.2, C49.2, C50.2, C51.2, C52.2, C53.2, C54.2, C55.2, C56.2, C57.2, C58.2, C59.2, C60.2, C61.2, C62.2, C63.2, C64.2, C65.2, C66.2, C67.2, C68.2, C69.2, C70.2, C71.2, C72.2, C73.2, C74.2, C75.2, C76.2, C77.2, C78.2, C79.2, C80.2, C81.2, C82.2, C83.2, C84.2, C85.2, C86.2, C87.2, R4.2, R6.2, TP52.1, TP53.1, TP54.1, TP55.1, TP56.1, TP57.1, TP58.1, U2.9 (GND), U3.1 (PGND), U3.6 (AGND), U3.11 (PGND), U4.1 (PGND), U4.4 (AGND), U4.5 (FB), U4.9 (PAD), U5.2 (GND)
MODE_5V: R4.1, U2.1 (MODE/SYNC)
PG_3V3: U4.8 (PG)
PG_5V: R7.1, U2.2 (PGOOD), U4.3 (EN), U5.3 (ON/~OFF)
PG_12V: U3.8 (PG)
SW_3V3: L3.1, U4.7 (SW)
SW_5V: C27.1, L1.1, U2.5 (SW)
SW_12V: C28.1, L2.1, U3.3 (NC), U3.12 (SW)
VCC_5V: C24.1, U2.7 (VCC)
VCC_12V: C26.1, U3.5 (VCC)
VOS_3V3: NT3.1, U4.6 (VOS)

Notes on the sheet:
Filtered Power Rails
DESIGN NOTE: XL drops around 45th harmonic.
DESIGN NOTE: Pi filter with inductor would give better EMC performance but has higher bulk capacitance requirements. Ferrite is a good compromise.
3.3V ± 0.5% 250mA Linear Regulator
DESIGN NOTE: X6S 10uF is marginally better (but worse DC bias derating) at a higher price.
Pi filter capacitor Impedance vs Frequency curve
5V ± 2.5% 600mA Buck Regulator (2.2MHz)
Voltage Regulators
LAYOUT NOTE: Route feedback traces away from switching node.
Capacitor and Ferrite Bead Parameters
Bulk capacitance Derating curve
DESIGN NOTE: MODE = LOW → Auto Mode
Power Rails
DESIGN NOTE: L = (VIN-VOUT)/(fSW*K*IOUT)*VOUT/VIN Computed with VIN = 50V, K = 0.15
Ground
12V ± 1.5% 600mA Buck Regulator (2.1MHz)
DESIGN NOTE: Effective capacitance at 33V is approximately 2.1 uF
LAYOUT NOTE: Minimize switching node loop areas.
DC-Link Bulk Capacitors. 48 x 4.7 uF = 225.6 uF (100.8 uF at 33V)
Test Points
Ferrite bead Impedance vs Frequency curve
DESIGN NOTE: An external precharge circuit is advised to charge the bulk capacitors if multiple boards are connected.
3.3V ± 3% 500mA Buck Regulator (2.25MHz)
Battery
[${#}] ${TITLE}
