Sdevaud/PCB/Power.kicad_sch

## KiCad design Power.kicad_sch (2026-11-09)

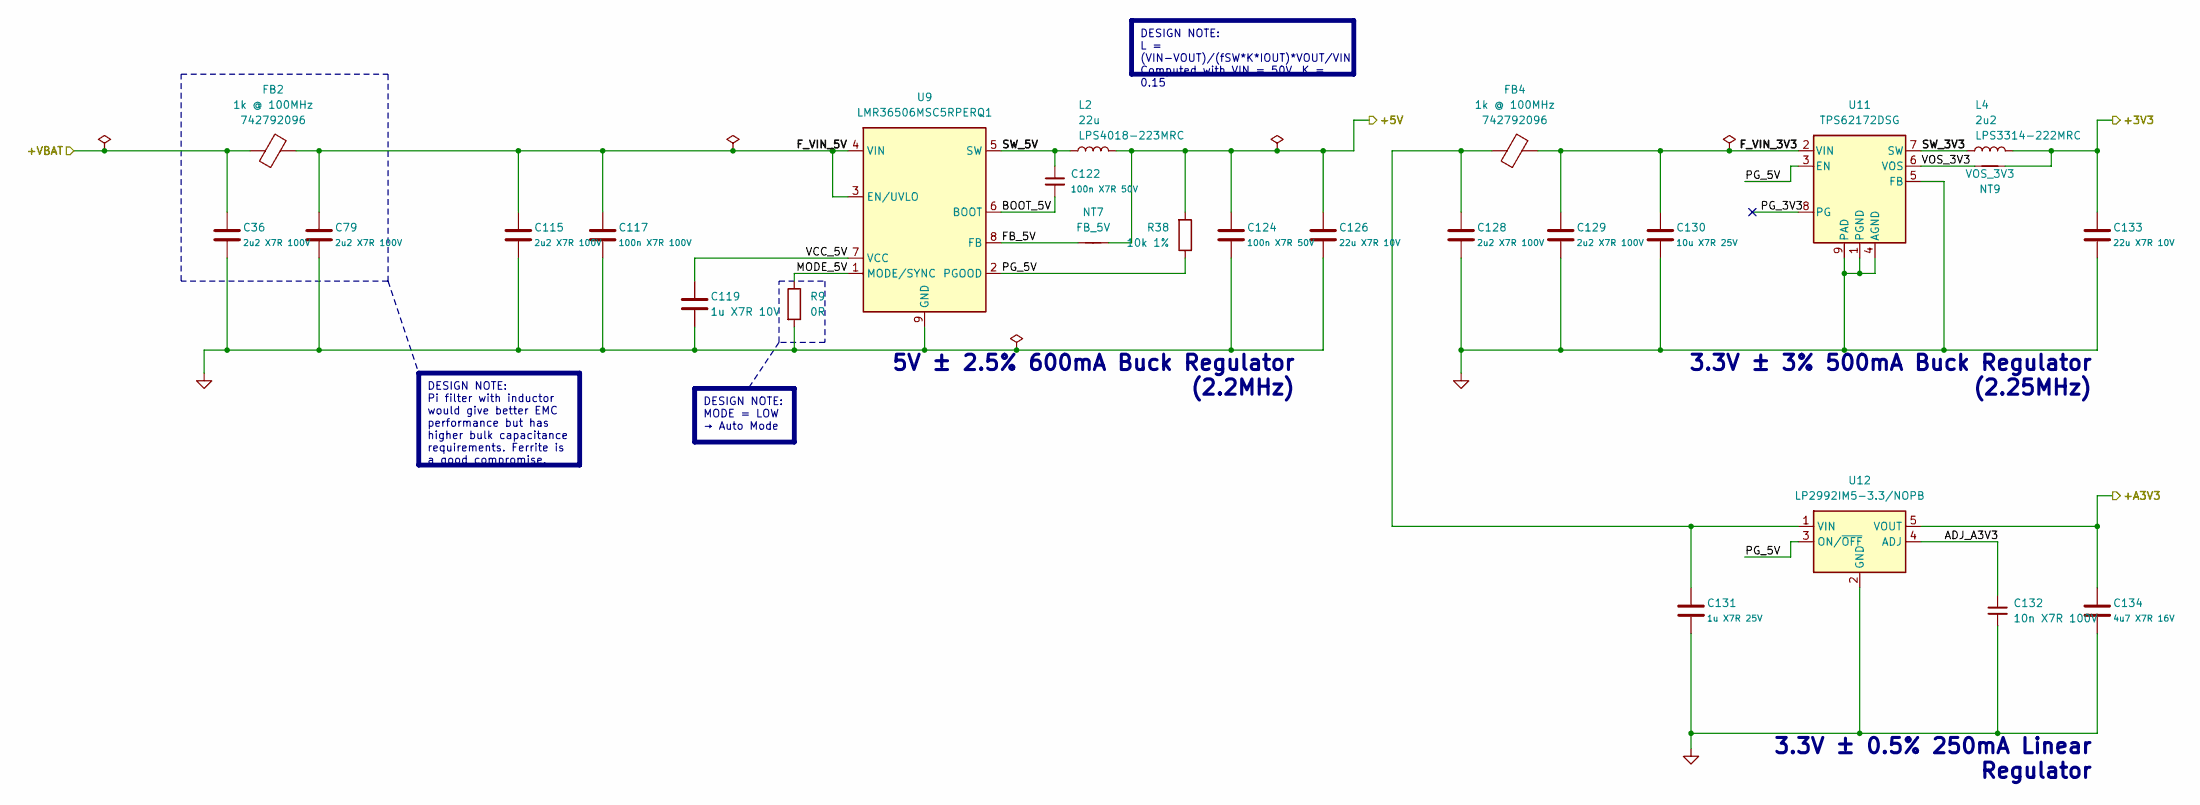
[picture p11: schematic Power.kicad_sch]

Parts:
C36, C79, C115, C128, C129: 2u2 X7R 100V; R_0805_2012_DensityHigh; Manufacturer Part Number CGA4J1X7R2A225K125AC
C117: 100n X7R 100V; C_0603_1608_DensityHigh; Manufacturer Part Number HMK107B7104KAHT
C119: 1u X7R 10V; C_0402_1005_DensityHigh; Manufacturer Part Number GRM155Z71A105KE01J
C122, C124: 100n X7R 50V; C_0402_1005_DensityHigh; Manufacturer Part Number GCM155R71H104KE02J
C126, C133: 22u X7R 10V; C_0805_2012_DensityHighest; Manufacturer Part Number GRM21BZ71A226ME15L
C130: 10u X7R 25V; C_0805_2012_DensityHighest; Manufacturer Part Number GRM21BZ71E106KE15L
C131: 1u X7R 25V; C_0603_1608_DensityHigh; Manufacturer Part Number TMK107AB7105KAHT
C132: 10n X7R 100V; C_0402_1005_DensityHigh; Manufacturer Part Number HMR105B7103KV-F
C134: 4u7 X7R 16V; C_0603_1608_DensityHigh; Manufacturer Part Number GRM188Z71C475KE21J
FB2, FB4: 1k @ 100MHz; R_0805_2012_DensityHigh; Manufacturer Part Number 742792096
L2: 22u; L_Coilcraft_LPS4018; Manufacturer Part Number LPS4018-223MRC
L4: 2u2; L_Coilcraft_LPS3314; Manufacturer Part Number LPS3314-222MRC
NT7: FB_5V; NetTie-2_SMD_Pad0.2mm
NT9: VOS_3V3; NetTie-2_SMD_Pad0.2mm
R9: 0R; R_0402_1005_DensityHigh; Manufacturer Part Number ERJ-2GE0R00X
R38: 10k 1%; R_0402_1005_DensityHigh; Manufacturer Part Number RT0402FRE0710KL
U9: LMR36506MSC5RPERQ1; LMR36503; Manufacturer Part Number LMR36503MSC5RPERQ1
U11: TPS62172DSG; WSON-8-1EP_2x2mm_P0.5mm_EP0.9x1.6mm_ThermalVias; Manufacturer Part Number TPS62172DSGR
U12: LP2992IM5-3.3/NOPB; SOT95P280X145-5N; Manufacturer Part Number LP2992IM5-3.3/NOPB

Connections:
+3V3: C133.1, L4.2, NT9.2
+5V: C124.1, C126.1, L2.2, NT7.1, R38.2
+A3V3: C134.1, U12.5 (VOUT)
+VBAT: C36.1, FB2.1
ADJ_A3V3: C132.1, U12.4 (ADJ)
BOOT_5V: C122.2, U9.6 (BOOT)
FB_5V: NT7.2, U9.8 (FB)
F_VIN_3V3: C129.1, C130.1, FB4.2, U11.2 (VIN)
F_VIN_5V: C79.1, C115.1, C117.1, FB2.2, U9.3 (EN/UVLO), U9.4 (VIN)
GND: C36.2, C79.2, C115.2, C117.2, C119.2, C124.2, C126.2, C128.2, C129.2, C130.2, C131.2, C132.2, C133.2, C134.2, R9.2, U9.9 (GND), U11.1 (PGND), U11.4 (AGND), U11.5 (FB), U11.9 (PAD), U12.2 (GND)
MODE_5V: R9.1, U9.1 (MODE/SYNC)
unnamed: C128.1, C131.1, FB4.1, U12.1 (VIN)
PG_3V3: U11.8 (PG)
PG_5V: R38.1, U9.2 (PGOOD), U11.3 (EN), U12.3 (ON/~OFF)
SW_3V3: L4.1, U11.7 (SW)
SW_5V: C122.1, L2.1, U9.5 (SW)
VCC_5V: C119.1, U9.7 (VCC)
VOS_3V3: NT9.1, U11.6 (VOS)

Notes on the sheet:
3.3V ± 0.5% 250mA Linear Regulator
DESIGN NOTE: Pi filter with inductor would give better EMC performance but has higher bulk capacitance requirements. Ferrite is a good compromise.
DESIGN NOTE: MODE = LOW → Auto Mode
DESIGN NOTE: L = (VIN-VOUT)/(fSW*K*IOUT)*VOUT/VIN Computed with VIN = 50V, K = 0.15
5V ± 2.5% 600mA Buck Regulator (2.2MHz)
3.3V ± 3% 500mA Buck Regulator (2.25MHz)
