Sdevaud/PCB/Power_stage.kicad_sch

## KiCad design Power_stage.kicad_sch (2026-11-09)

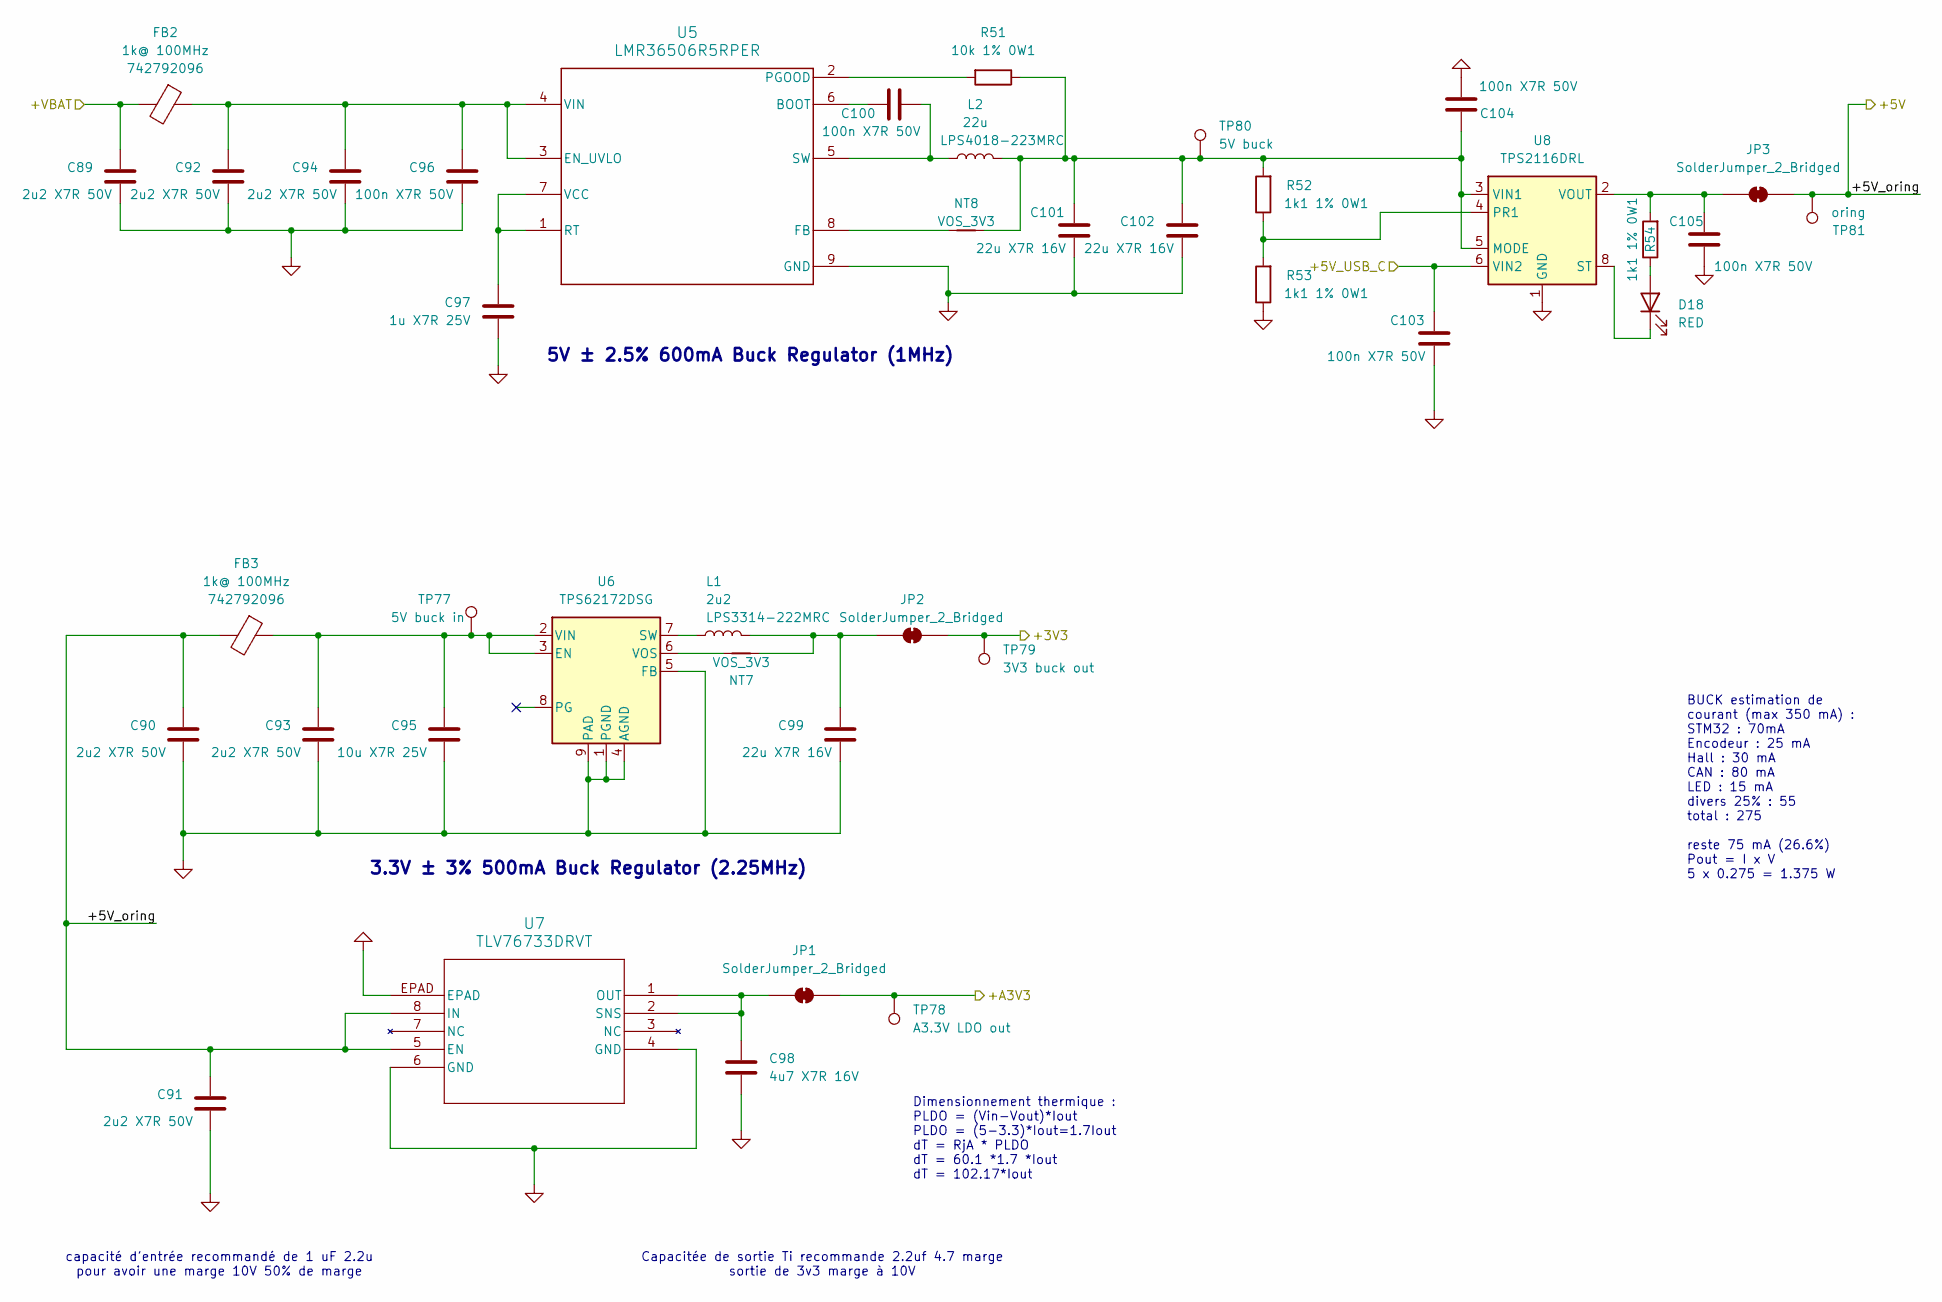
[picture p12: schematic Power_stage.kicad_sch]

Parts:
C89, C90, C91, C92, C93, C94: 2u2 X7R 50V; C_0805_2012Metric
C95: 10u X7R 25V; C_0805_2012Metric
C96, C100, C103, C104, C105: 100n X7R 50V; C_0603_1608Metric
C97: 1u X7R 25V; C_0603_1608Metric
C98: 4u7 X7R 16V; C_0805_2012Metric
C99, C101, C102: 22u X7R 16V; C_1210_3225Metric
D18: RED; SOT-583-8
FB2, FB3: 1k@ 100MHz; R_0805_2012_DensityHigh
JP1, JP2, JP3: SolderJumper_2_Bridged; SolderJumper-2_P1.3mm_Bridged_Pad1.0x1.5mm
L1: 2u2; L_Coilcraft_LPS3314; Manufacturer Part Number LPS3314-222MRC
L2: 22u; L_Coilcraft_LPS4018
NT7, NT8: VOS_3V3; NetTie-2_SMD_Pad0.5mm
R51: 10k 1% 0W1; R_0603_1608Metric
R52, R53, R54: 1k1 1% 0W1; R_0603_1608Metric
TP77: 5V buck in; TestPoint_Pad_D2.0mm
TP78: A3.3V LDO out; TestPoint_Pad_D2.0mm
TP79: 3V3 buck out; TestPoint_Pad_D2.0mm
TP80: 5V buck; TestPoint_Pad_D2.0mm
TP81: oring; TestPoint_Pad_D2.0mm
U5: LMR36506R5RPER; RPE0009A-MFG
U6: TPS62172DSG; Texas_DSG0008A_WSON-8-1EP_2x2mm_P0.5mm_EP0.9x1.6mm_ThermalV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
U7: TLV76733DRVT; WSON-6-1EP_2x2mm_P0.65mm_EP1x1.6mm_ThermalVias
U8: TPS2116DRL; SOT-583-8

Connections:
+3V3: JP2.2 (B), TP79.1
+5V: C90.1, C91.1, FB3.2, JP3.2 (B), TP81.1, U7.5 (EN), U7.8 (IN)
+5V_USB_C: C103.1, U8.6 (VIN2)
+A3V3: JP1.2 (B), TP78.1
+VBAT: C89.1, FB2.2
GND: C89.2, C90.2, C91.2, C92.2, C93.2, C94.2, C95.2, C96.2, C97.2, C98.2, C99.2, C101.2, C102.2, C103.2, C104.2, C105.2, R53.1, U5.9 (GND), U6.1 (PGND), U6.4 (AGND), U6.5 (FB), U6.9 (PAD), U7.4 (GND), U7.6 (GND), U7.EPAD, U8.1 (GND)
unnamed: C92.1, C94.1, C96.1, FB2.1, U5.3 (EN_UVLO), U5.4 (VIN)
unnamed: C93.1, C95.1, FB3.1, TP77.1, U6.2 (VIN), U6.3 (EN)
unnamed: C97.1, U5.1 (RT), U5.7 (VCC)
unnamed: C98.1, JP1.1 (A), U7.1 (OUT), U7.2 (SNS)
unnamed: C99.1, JP2.1 (A), L1.2, NT7.2
unnamed: C100.1, U5.6 (BOOT)
unnamed: C100.2, L2.1, U5.5 (SW)
unnamed: C101.1, C102.1, C104.1, L2.2, NT8.1, R51.1, R52.2, TP80.1, U8.3 (VIN1), U8.5 (MODE)
unnamed: C105.1, JP3.1 (A), R54.2, U8.2 (VOUT), U8.7 (VOUT)
unnamed: D18.1 (K), U8.8 (ST)
unnamed: D18.2 (A), R54.1
unnamed: L1.1, U6.7 (SW)
unnamed: NT7.1, U6.6 (VOS)
unnamed: NT8.2, U5.8 (FB)
unnamed: R51.2, U5.2 (PGOOD)
unnamed: R52.1, R53.2, U8.4 (PR1)

Notes on the sheet:
3.3V ± 3% 500mA Buck Regulator (2.25MHz)
5V ± 2.5% 600mA Buck Regulator (1MHz)
capacité d'entrée recommandé de 1 uF 2.2u pour avoir une marge 10V 50% de marge
BUCK estimation de courant (max 350 mA) : STM32 : 70mA Encodeur : 25 mA Hall : 30 mA CAN : 80 mA LED : 15 mA divers 25% : 55 total : 275 reste 75 mA (26.6%) Pout = I x V 5 x 0.275 = 1.375 W
Capacitée de sortie Ti recommande 2.2uf 4.7 marge sortie de 3v3 marge à 10V
Dimensionnement thermique : PLDO = (Vin-Vout)*Iout PLDO = (5-3.3)*Iout=1.7Iout dT = RjA * PLDO dT = 60.1 *1.7 *Iout dT = 102.17*Iout
