Sdevaud/PCB/Sensing.kicad_sch

## KiCad design Sensing.kicad_sch (2026-11-09)

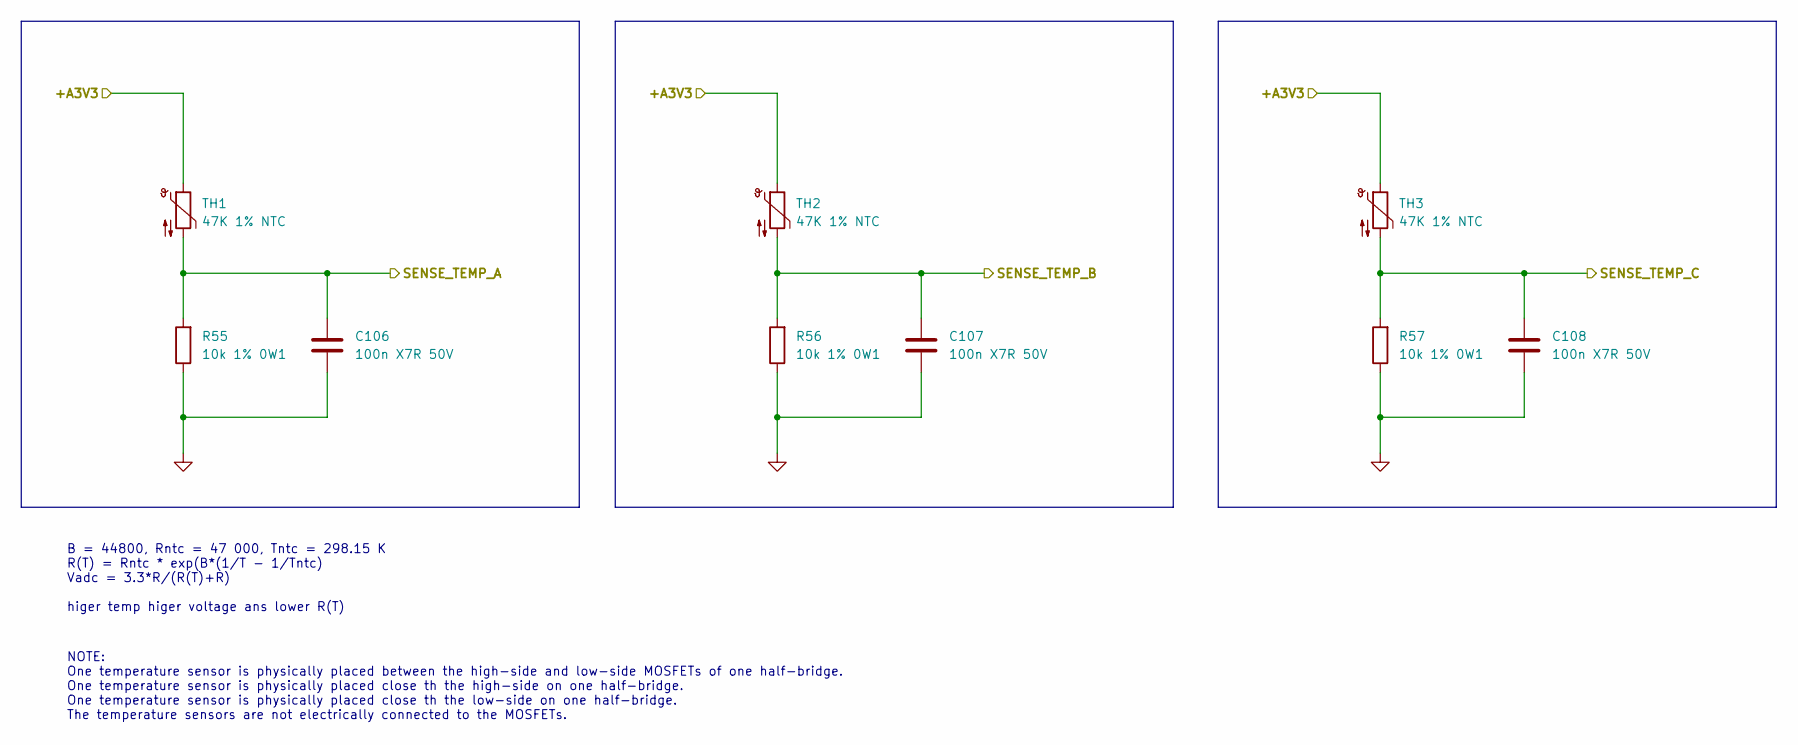
[picture p13: schematic Sensing.kicad_sch]

Parts:
C106, C107, C108: 100n X7R 50V; C_0603_1608Metric
R55, R56, R57: 10k 1% 0W1; R_0603_1608Metric
TH1, TH2, TH3: 47K 1% NTC; R_0603_1608Metric

Connections:
+A3V3: TH1.1, TH2.1, TH3.1
GND: C106.2, C107.2, C108.2, R55.1, R56.1, R57.1
SENSE_TEMP_A: C106.1, R55.2, TH1.2
SENSE_TEMP_B: C107.1, R56.2, TH2.2
SENSE_TEMP_C: C108.1, R57.2, TH3.2

Notes on the sheet:
B = 44800, Rntc = 47 000, Tntc = 298.15 K R(T) = Rntc * exp(B*(1/T - 1/Tntc) Vadc = 3.3*R/(R(T)+R) higer temp higer voltage ans lower R(T)
NOTE: One temperature sensor is physically placed between the high-side and low-side MOSFETs of one half-bridge. One temperature sensor is physically placed close th the high-side on one half-bridge. One temperature sensor is physically placed close th the low-side on one half-bridge. The temperatu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
