Sdevaud/PCB/driver.kicad_sch

## KiCad design driver.kicad_sch (2026-11-09)

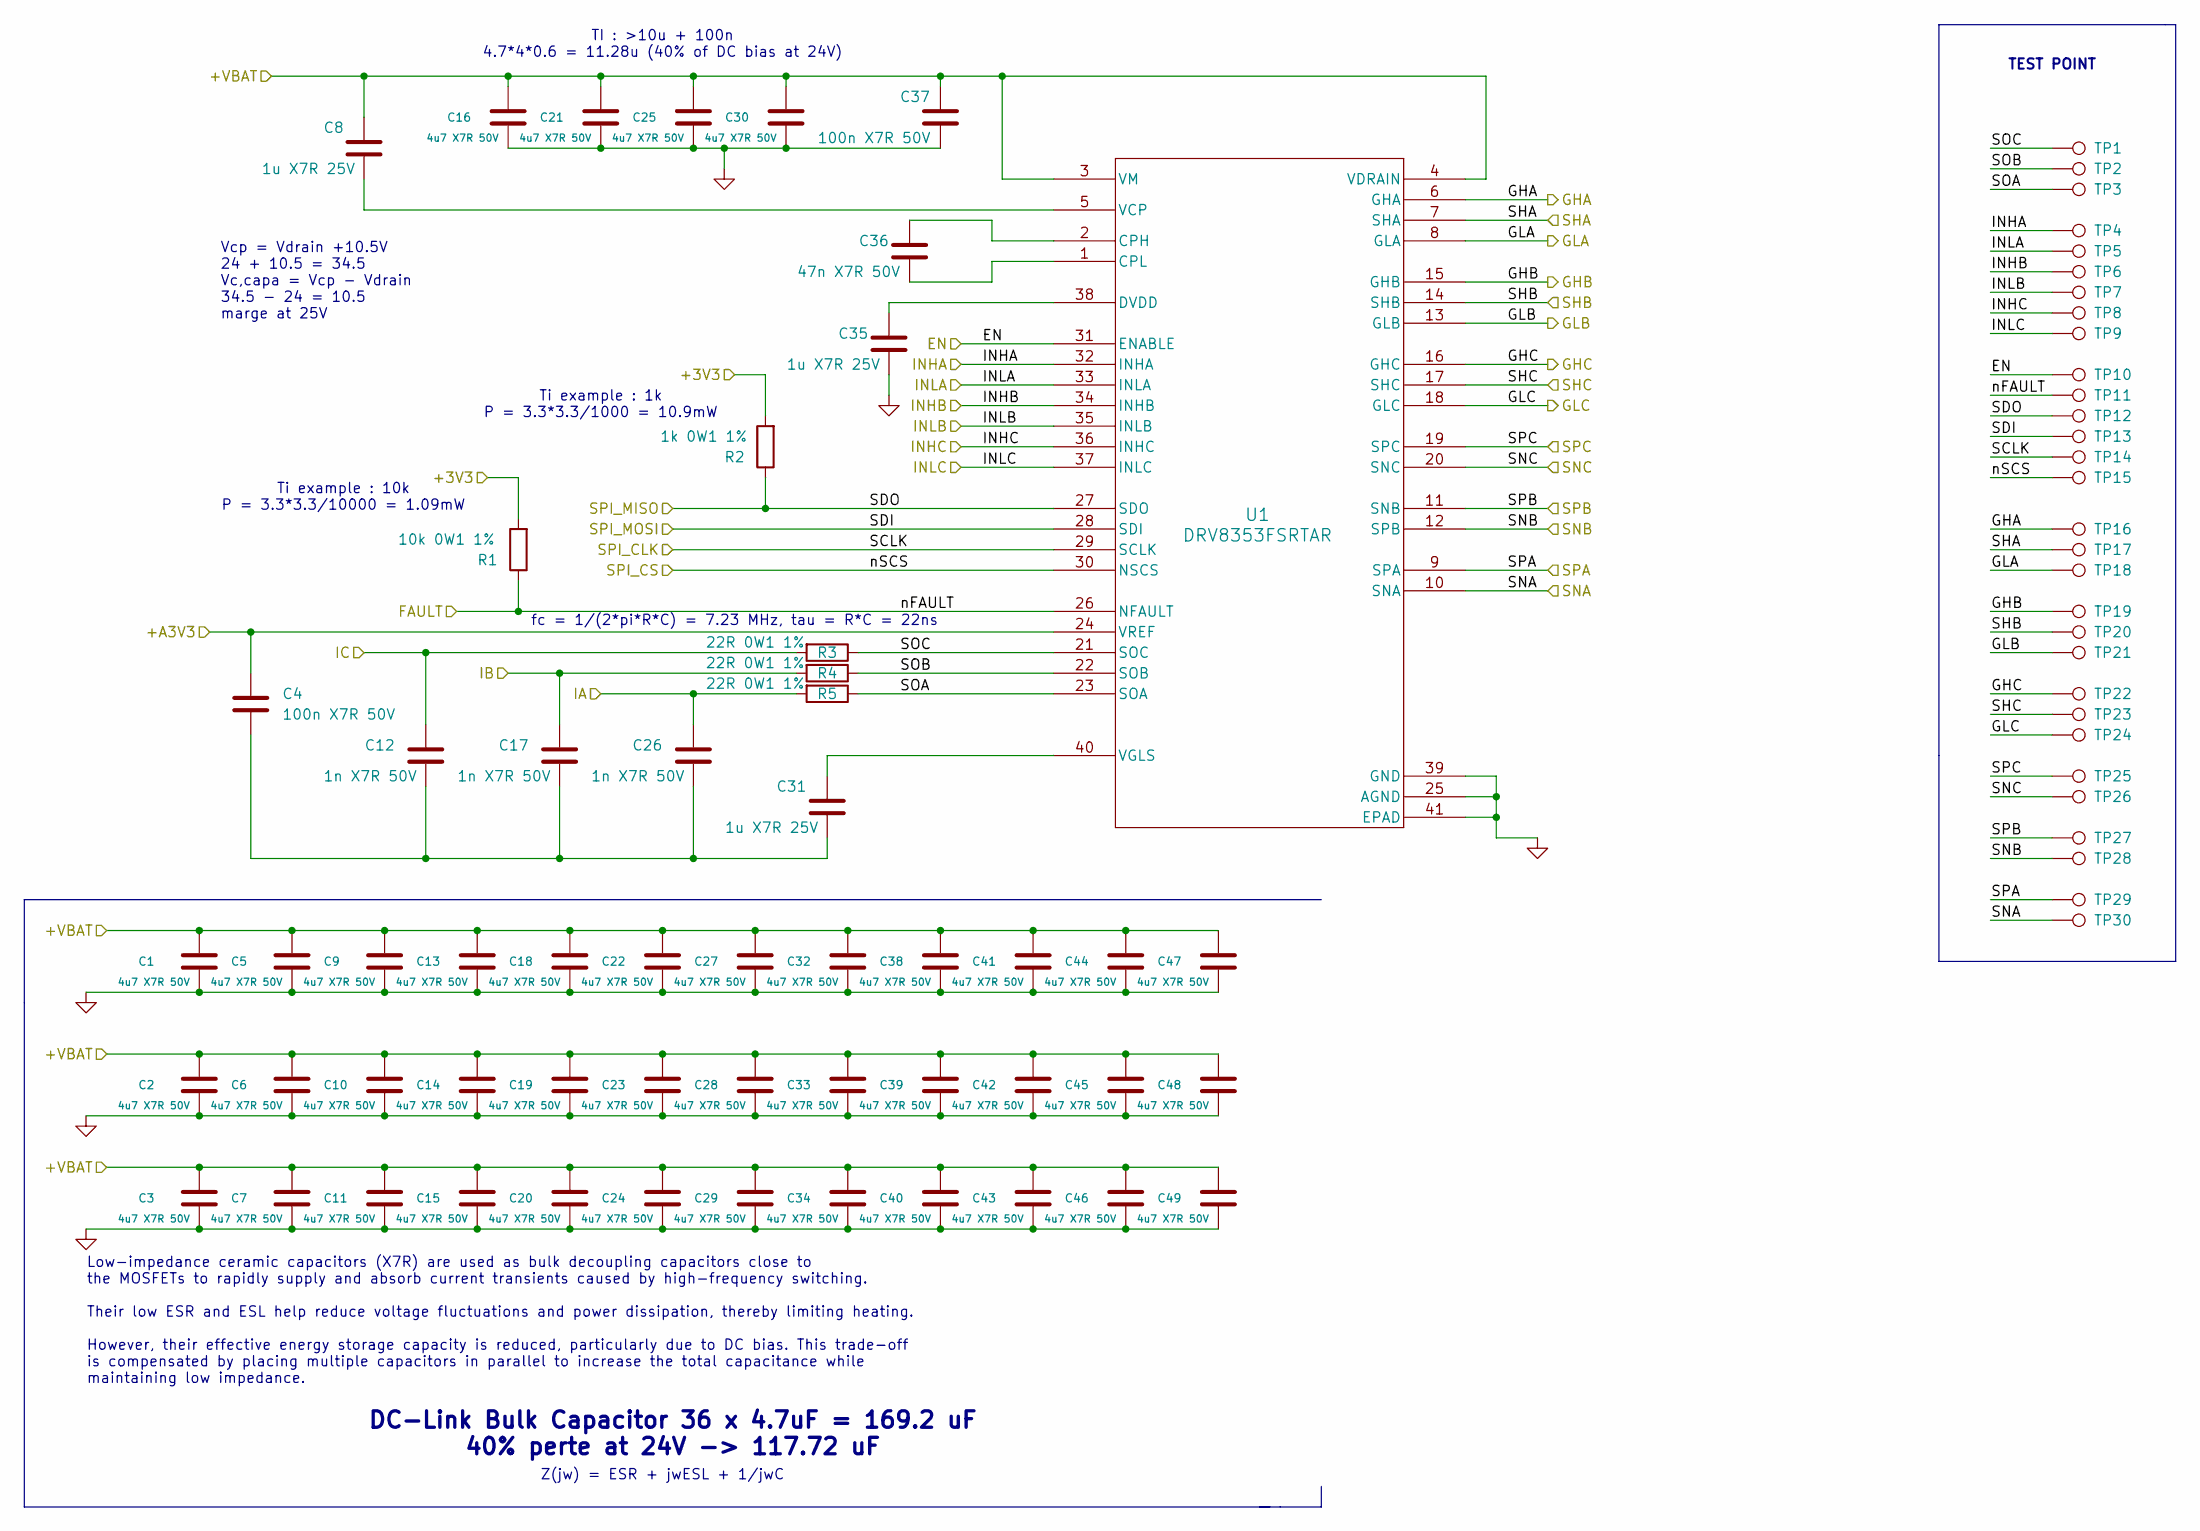
[picture p14: schematic driver.kicad_sch]

Parts:
C1, C2, C3, C5, C6, C7, C9, C10, C11, C13, C14, C15, C16, C18, C19, C20, C21, C22, C23, C24, C25, C27, C28, C29, C30, C32, C33, C34, C38, C39, C40, C41, C42, C43, C44, C45, C46, C47, C48, C49: 4u7 X7R 50V; C_1210_3225Metric
C4, C37: 100n X7R 50V; C_0603_1608Metric
C8, C31, C35: 1u X7R 25V; C_0603_1608Metric
C12, C17, C26: 1n X7R 50V; C_0603_1608Metric
C36: 47n X7R 50V; C_0603_1608Metric
R1: 10k 0W1 1%; R_0603_1608Metric
R2: 1k 0W1 1%; R_0603_1608Metric
R3, R4, R5: 22R 0W1 1%; R_0603_1608Metric
TP1, TP2, TP3, TP4, TP5, TP6, TP7, TP8, TP9, TP10, TP11, TP12, TP13, TP14, TP15, TP16, TP17, TP18, TP19, TP20, TP21, TP22, TP23, TP24, TP25, TP26, TP27, TP28, TP29, TP30: TestPoint; TestPoint_Pad_D2.0mm
U1: DRV8353FSRTAR; WQFN40_RTA_TEX

Connections:
+3V3: R1.2, R2.2
+A3V3: C4.1, U1.24 (VREF)
+VBAT: C1.1, C2.1, C3.1, C5.1, C6.1, C7.1, C8.1, C9.1, C10.1, C11.1, C13.1, C14.1, C15.1, C16.1, C18.1, C19.1, C20.1, C21.1, C22.1, C23.1, C24.1, C25.1, C27.1, C28.1, C29.1, C30.1, C32.1, C33.1, C34.1, C37.1, C38.1, C39.1, C40.1, C41.1, C42.1, C43.1, C44.1, C45.1, C46.1, C47.1, C48.1, C49.1, U1.3 (VM), U1.4 (VDRAIN)
EN: TP10.1, U1.31 (ENABLE)
FAULT: R1.1, TP11.1, U1.26 (NFAULT)
GHA: TP16.1, U1.6 (GHA)
GHB: TP19.1, U1.15 (GHB)
GHC: TP22.1, U1.16 (GHC)
GLA: TP18.1, U1.8 (GLA)
GLB: TP21.1, U1.13 (GLB)
GLC: TP24.1, U1.18 (GLC)
GND: C1.2, C2.2, C3.2, C5.2, C6.2, C7.2, C9.2, C10.2, C11.2, C13.2, C14.2, C15.2, C16.2, C18.2, C19.2, C20.2, C21.2, C22.2, C23.2, C24.2, C25.2, C27.2, C28.2, C29.2, C30.2, C32.2, C33.2, C34.2, C35.2, C37.2, C38.2, C39.2, C40.2, C41.2, C42.2, C43.2, C44.2, C45.2, C46.2, C47.2, C48.2, C49.2, U1.25 (AGND), U1.39 (GND), U1.41 (EPAD)
IA: C26.1, R5.2
IB: C17.1, R4.2
IC: C12.1, R3.2
INHA: TP4.1, U1.32 (INHA)
INHB: TP6.1, U1.34 (INHB)
INHC: TP8.1, U1.36 (INHC)
INLA: TP5.1, U1.33 (INLA)
INLB: TP7.1, U1.35 (INLB)
INLC: TP9.1, U1.37 (INLC)
unnamed: C8.2, U1.5 (VCP)
unnamed: C4.2, C12.2, C17.2, C26.2, C31.2
unnamed: C31.1, U1.40 (VGLS)
unnamed: C35.1, U1.38 (DVDD)
unnamed: C36.1, U1.2 (CPH)
unnamed: C36.2, U1.1 (CPL)
SCLK: TP14.1, U1.29 (SCLK)
SDI: TP13.1, U1.28 (SDI)
SDO: R2.1, TP12.1, U1.27 (SDO)
SHA: TP17.1, U1.7 (SHA)
SHB: TP20.1, U1.14 (SHB)
SHC: TP23.1, U1.17 (SHC)
SNA: TP30.1, U1.10 (SNA)
SNB: TP28.1, U1.12 (SPB)
SNC: TP26.1, U1.20 (SNC)
SOA: R5.1, TP3.1, U1.23 (SOA)
SOB: R4.1, TP2.1, U1.22 (SOB)
SOC: R3.1, TP1.1, U1.21 (SOC)
SPA: TP29.1, U1.9 (SPA)
SPB: TP27.1, U1.11 (SNB)
SPC: TP25.1, U1.19 (SPC)
nSCS: TP15.1, U1.30 (NSCS)

Notes on the sheet:
Ti example : 1k P = 3.3*3.3/1000 = 10.9mW
fc = 1/(2*pi*R*C) = 7.23 MHz, tau = R*C = 22ns
Z(jw) = ESR + jwESL + 1/jwC
Vcp = Vdrain +10.5V 24 + 10.5 = 34.5 Vc,capa = Vcp - Vdrain 34.5 - 24 = 10.5 marge at 25V
TEST POINT
Low-impedance ceramic capacitors (X7R) are used as bulk decoupling capacitors close to the MOSFETs to rapidly supply and absorb current transients caused by high-frequency switching. Their low ESR and ESL help reduce voltage fluctuations and power dissipation, thereby limiting heating. However, the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
Ti example : 10k P = 3.3*3.3/10000 = 1.09mW
DC-Link Bulk Capacitor 36 x 4.7uF = 169.2 uF 40% perte at 24V -> 117.72 uF
TI : >10u + 100n 4.7*4*0.6 = 11.28u (40% of DC bias at 24V)
