Sdevaud/PCB/motor.kicad_sch

## KiCad design motor.kicad_sch (2026-11-09)

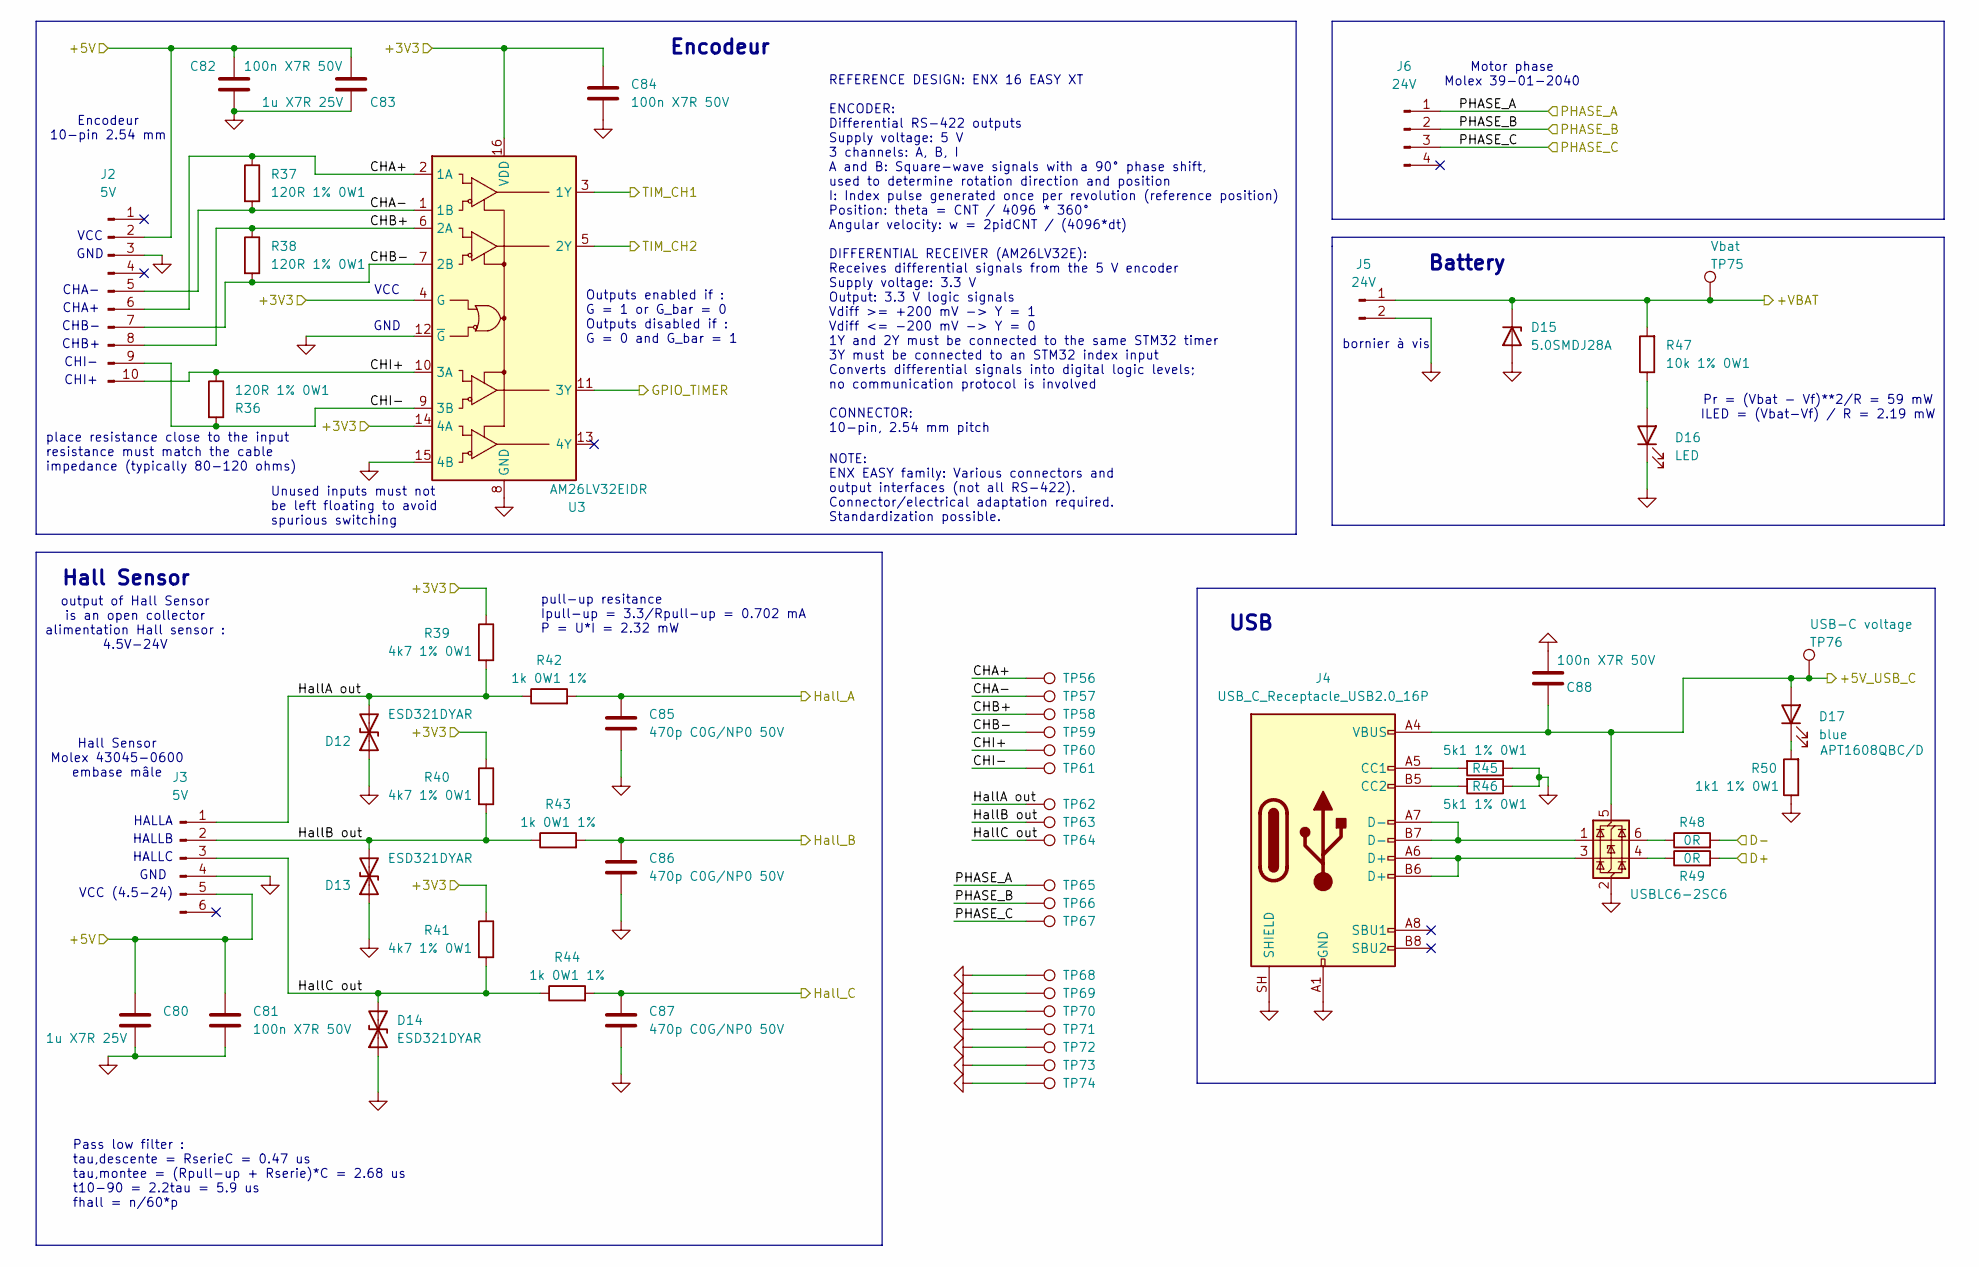
[picture p15: schematic motor.kicad_sch]

Parts:
C80, C83: 1u X7R 25V; C_0603_1608Metric
C81, C82, C84, C88: 100n X7R 50V; C_0603_1608Metric
C85, C86, C87: 470p C0G/NP0 50V; C_0603_1608Metric
D12, D13, D14: ESD321DYAR; D_SOD-523
D15: 5.0SMDJ28A; D_SMC
D16: LED; LED_Cree-XHP50_3V_HighDensity
D17: blue; LED_1206_3216Metric
J2: 5V; PinHeader_2x05_P2.54mm_Vertical
J3: 5V; Molex_Micro-Fit_3.0_43045-0600_2x03_P3.00mm_Horizontal
J4: USB_C_Receptacle_USB2.0_16P; USB_C_Receptacle_GCT_USB4085
J5: 24V; PHOENIX_1714971
J6: 24V; Molex_Mini-Fit_Jr_5566-04A_2x02_P4.20mm_Vertical
R36, R37, R38: 120R 1% 0W1; R_0603_1608Metric
R39, R40, R41: 4k7 1% 0W1; R_0603_1608Metric
R42, R43, R44: 1k 0W1 1%; R_0603_1608Metric
R45, R46: 5k1 1% 0W1; R_0603_1608Metric
R47: 10k 1% 0W1; R_0603_1608Metric
R48, R49: 0R; R_0603_1608Metric
R50: 1k1 1% 0W1; R_0603_1608Metric
TP56, TP57, TP58, TP59, TP60, TP61, TP62, TP63, TP64, TP65, TP66, TP67, TP68, TP69, TP70, TP71, TP72, TP73, TP74: TestPoint; TestPoint_Pad_D2.0mm
TP75: Vbat; TestPoint_Pad_D2.0mm
TP76: USB-C voltage; TestPoint_Pad_D2.0mm
U3: AM26LV32EIDR; SOIC-16_3.9x9.9mm_P1.27mm
U4: USBLC6-2SC6; SOT-23-6

Connections:
+3V3: C84.1, R39.1, R40.1, R41.1, U3.4 (G), U3.14 (4A), U3.16 (VDD)
+5V: C80.1, C81.1, C82.1, C83.1, J2.2, J3.5
+5V_USB_C: C88.1, D17.2 (A), J4.A4 (VBUS), J4.A9 (VBUS), J4.B4 (VBUS), J4.B9 (VBUS), TP76.1, U4.5 (VBUS)
+VBAT: D15.1 (K), J5.1, R47.2, TP75.1
CHA+: J2.6, R37.1, TP56.1, U3.2 (1A)
CHA-: J2.5, R37.2, TP57.1, U3.1 (1B)
CHB+: J2.8, R38.1, TP58.1, U3.6 (2A)
CHB-: J2.7, R38.2, TP59.1, U3.7 (2B)
CHI+: J2.10, R36.1, TP60.1, U3.10 (3A)
CHI-: J2.9, R36.2, TP61.1, U3.9 (3B)
D+: R49.2
D-: R48.2
GND: C80.2, C81.2, C82.2, C83.2, C84.2, C85.2, C86.2, C87.2, C88.2, D12.1 (A1), D13.1 (A1), D14.1 (A1), D15.2 (A), D16.1 (K), J2.3, J3.4, J4.A1 (GND), J4.A12 (GND), J4.B1 (GND), J4.B12 (GND), J4.SH (SHIELD), J5.2, R45.1, R46.1, R50.1, TP68.1, TP69.1, TP70.1, TP71.1, TP72.1, TP73.1, TP74.1, U3.8 (GND), U3.12 (~G), U3.15 (4B), U4.2 (GND)
GPIO_TIMER: U3.11 (3Y)
HallA out: D12.2 (A2), J3.1, R39.2, R42.1, TP62.1
HallB out: D13.2 (A2), J3.2, R40.2, R43.1, TP63.1
HallC out: D14.2 (A2), J3.3, R41.2, R44.1, TP64.1
Hall_A: C85.1, R42.2
Hall_B: C86.1, R43.2
Hall_C: C87.1, R44.2
unnamed: D16.2 (A), R47.1
unnamed: D17.1 (K), R50.2
unnamed: J4.A5 (CC1), R45.2
unnamed: J4.A6 (D+), J4.B6 (D+), U4.3 (I/O2)
unnamed: J4.A7 (D-), J4.B7 (D-), U4.1 (I/O1)
unnamed: J4.B5 (CC2), R46.2
unnamed: R48.1, U4.6 (I/O1)
unnamed: R49.1, U4.4 (I/O2)
PHASE_A: J6.1, TP65.1
PHASE_B: J6.2, TP66.1
PHASE_C: J6.3, TP67.1
TIM_CH1: U3.3 (1Y)
TIM_CH2: U3.5 (2Y)

Notes on the sheet:
Motor phase Molex 39-01-2040
output of Hall Sensor is an open collector alimentation Hall sensor : 4.5V-24V
CHI-
VCC
Battery
Encodeur 10-pin 2.54 mm
VCC (4.5-24)
CHA+
NOTE: ENX EASY family: Various connectors and output interfaces (not all RS-422). Connector/electrical adaptation required. Standardization possible.
CHB+
HALLC
CHB-
USB
Pr = (Vbat - Vf)**2/R = 59 mW ILED = (Vbat-Vf) / R = 2.19 mW
GND
CHI+
Encodeur
Outputs enabled if : G = 1 or G_bar = 0 Outputs disabled if : G = 0 and G_bar = 1
Hall Sensor
HALLB
HALLA
GND
pull-up resitance Ipull-up = 3.3/Rpull-up = 0.702 mA P = U*I = 2.32 mW
place resistance close to the input resistance must match the cable impedance (typically 80-120 ohms)
REFERENCE DESIGN: ENX 16 EASY XT ENCODER: Differential RS-422 outputs Supply voltage: 5 V 3 channels: A, B, I A and B: Square-wave signals with a 90° phase shift, used to determine rotation direction and position I: Index pulse generated once per revolution (reference position) Position: theta = CN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
Pass low filter : tau,descente = RserieC = 0.47 us tau,montee = (Rpull-up + Rserie)*C = 2.68 us t10-90 = 2.2tau = 5.9 us fhall = n/60*p
CHA-
Unused inputs must not be left floating to avoid spurious switching
bornier à vis
Hall Sensor Molex 43045-0600 embase mâle
