Sdevaud/PCB/(commit log)

2026-10-26 Initial commit - KiCad PCB
2026-10-28 DRV et etage de puissance
2026-11-09 finish foot print
